bouge13a/pd_midi_synth/hardware/looper pins.xlsx

Looper board
PIN | NET name | pin type | Details
PE3 | "pad 0" | adc | to 10k pot
PE2 | "pad 1" | adc | to 10k pot
PE1 | "pad 2" | adc | to 10k pot
PE0 | "pad 3" | adc | to 10k pot
PD3 | "pad 4" | adc | to 10k pot
PD2 | "pad 5" | adc | to 10k pot
PD1 | "pad 6" | adc | to 10k pot
PD7 | "pad 7" | adc | to 10k pot
PE5 | "pad 8" | adc | to 10k fader
PE4 | "pad 9" | adc | to 10k fader
PB4 | "pad 10" | adc | to 10k fader
PB5 | "pad 11" | adc | to 10k fader
PA6 | "i2c 1 SCL" | I2C SCL | 4.7k pullup resistor
PA7 | "i2c 1 SDA" | I2C SDA | 4.7k pullup resistor
PB2 | "board sel" | GPI | to Vdd
PA0 | "UART0Rx" | UART RX | serial debug terminal
PA1 | "UART0Tx" | UART TX | serial debug terminal
PF3 | "green debug" | GPO | Green surface mount debug LED
PF1 | "red debug" | GPO | Red surface mount debug LED
PB1 | "led 0" | GPO | to momentary push button lamp
PF4 | "led 1" | GPO | to momentary push button lamp
PB6 | "led 2" | GPO | to momentary push button lamp
PB7 | "led 3" | GPO | to momentary push button lamp
PF0 | "led 4" | GPO | to momentary push button lamp
PB2 | "led 5" | GPO | to momentary push button lamp
PF0 | "led 6" | GPO | to momentary push button lamp
PB7 | "led 7" | GPO | to momentary push button lamp
PB0 | "loop 0" | GPI | to momentary push button
PB6 | "loop 1" | GPI | to momentary push button
PB3 | "loop 2" | GPI | to momentary push button
PA4 | "loop 3" | GPI | to momentary push button
PA5 | "loop 4" | GPI | to momentary push button
PC6 | "loop 5" | GPI | to momentary push button
PC7 | "loop 6" | GPI | to momentary push button
PD6 | "loop 7" | GPI | to momentary push button
PF2 | "effect button" | GPI | to momentary push button
PC4 | "UART1Rx" | UART Rx
PC5 | "UART1Tx" | UART Tx
