bouge13a/pd_midi_synth/hardware/MIDI controller pins.xlsx

MCU I, Midi Controller
PIN | NET name | pin type | Details
PE3 | "pad 0" | adc | forse sensing resistor/100k resistor voltage divider
PE2 | "pad 1" | adc | forse sensing resistor/100k resistor voltage divider
PE1 | "pad 2" | adc | forse sensing resistor/100k resistor voltage divider
PE0 | "pad 3" | adc | forse sensing resistor/100k resistor voltage divider
PD3 | "pad 4" | adc | forse sensing resistor/100k resistor voltage divider
PD2 | "pad 5" | adc | forse sensing resistor/100k resistor voltage divider
PD1 | "pad 6" | adc | forse sensing resistor/100k resistor voltage divider
PD7 | "pad 7" | adc | forse sensing resistor/100k resistor voltage divider
PE5 | "pad 8" | adc | forse sensing resistor/100k resistor voltage divider
PE4 | "pad 9" | adc | forse sensing resistor/100k resistor voltage divider
PB4 | "pad 10" | adc | forse sensing resistor/100k resistor voltage divider
PB5 | "pad 11" | adc | forse sensing resistor/100k resistor voltage divider
PA6 | "I2C1SCL" | I2C SCL | 4.7k pullup resistor
PA7 | "I2C1SDA" | I2C SDA | 4.7k pullup resistor
PB2 | "board sel" | GPI | to ground
PA0 | "UART0Rx" | UART RX | serial debug terminal
PA1 | "UART0Tx" | UART TX | serial debug terminal
PF3 | "green debug" | GPO | Green surface mount debug LED
PF1 | "red debug" | GPO | Red surface mount debug LED
PF4 | "channel up" | GPI | momentary push button
PD7 | "channel down" | GPI | momentary push button
PC6 | "p sense" | GPI | latching push button
PC7 | "octave up" | GPI | momentary push button
PD6 | "octave down" | GPI | momentary push button
PA5 | "SSI0Tx" | SSI Tx | to seven segment display
PA4 | "SSI0RX" | SSI Rx | to seven segment display
PA3 | "SSI0Fss" | SSI Fss | to seven segment display
PA2 | "SSI0CLK" | SSI CLK | to seven segment display
PC4 | "UART1Rx" | UART Rx
PC5 | "UART1Tx" | UART Tx
