bouge13a/pd_midi_synth/hardware/Top Part.JPG

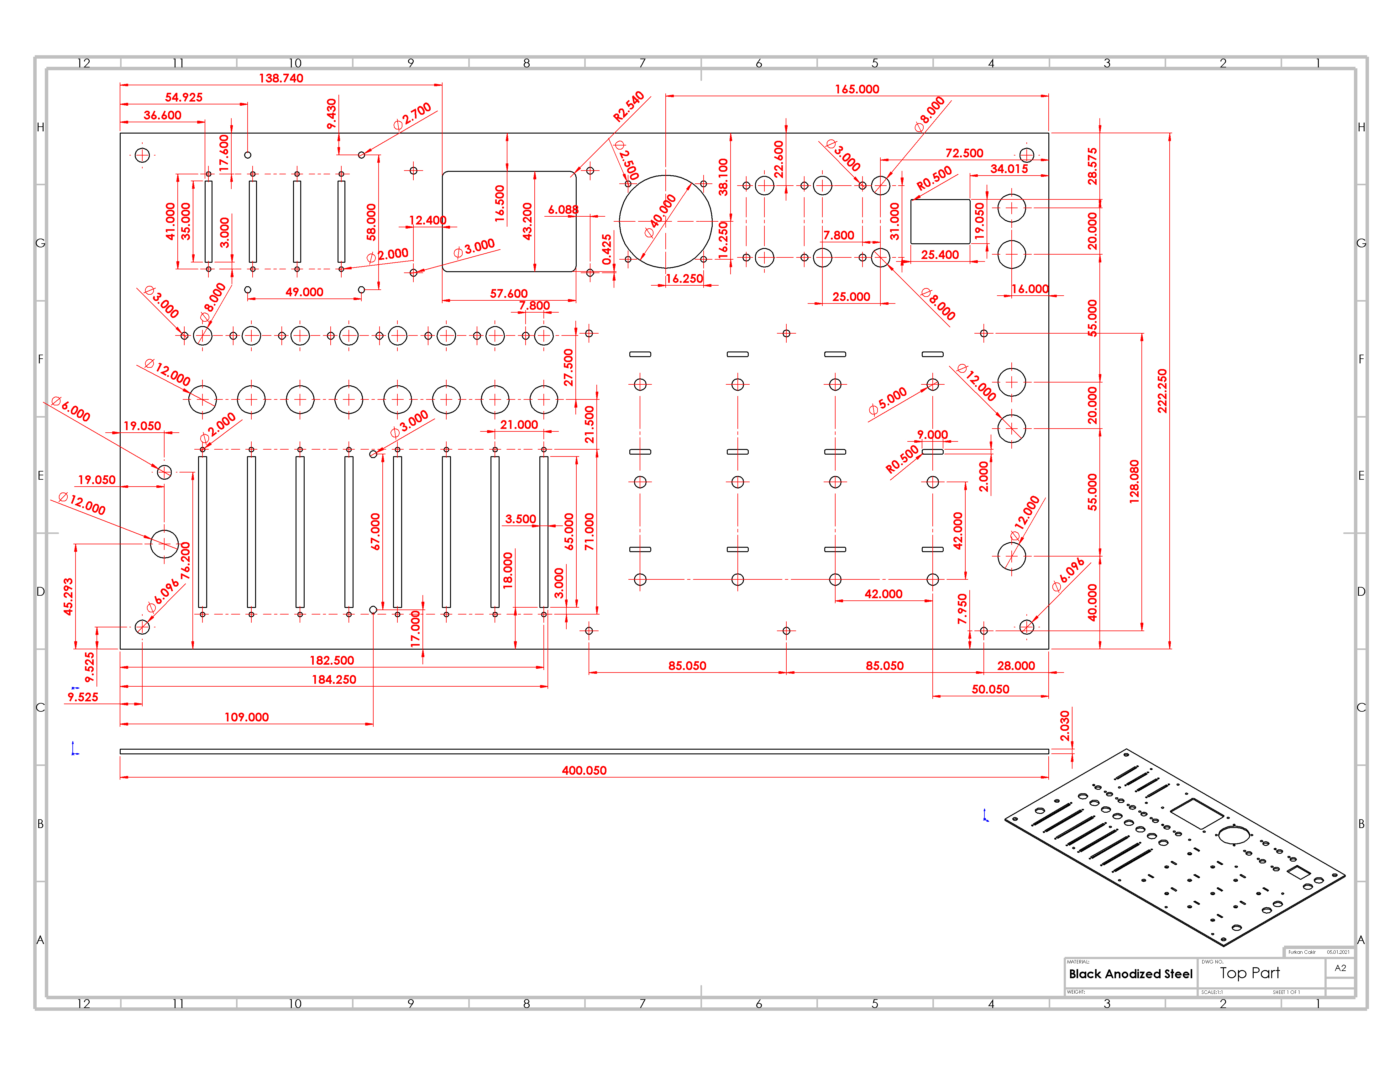
hardware/Top Part.JPG
