bouge13a/pd_midi_synth/hardware/Assembly.STEP

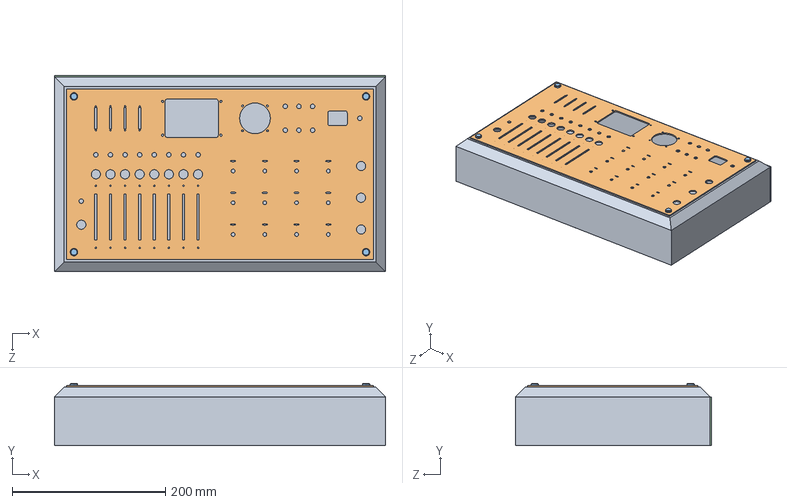
[picture p2: CAD file, 2022-02-10]
hardware/Assembly.STEP
431.8 x 81.2 x 256.0 mm
Base
Top
Screw x 4
Side
