bouge13a/pd_midi_synth/hardware/Top Part.STEP

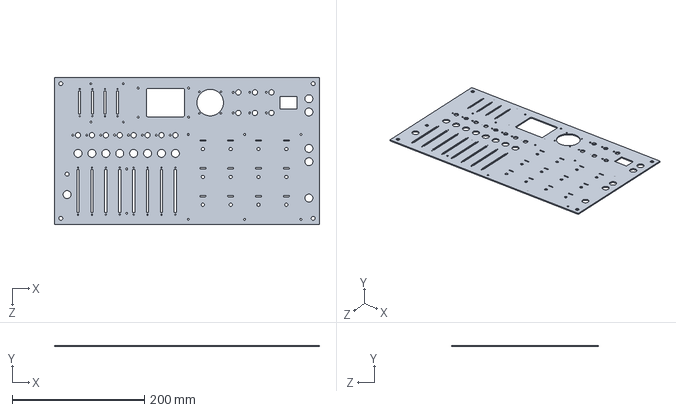
[picture p3: CAD file, 2022-02-10]
hardware/Top Part.STEP
400.1 x 2.03 x 222.2 mm
