bouge13a/pd_midi_synth/(list of files, cad)

Other CAD files:
Debug/driverlib/crc.obj
Debug/usb_midi/usbmidi_handlers.obj
Debug/utils/ustdlib.obj
Debug/driverlib/gpio.obj
Debug/usb_midi/usbmidi.obj
Debug/utils/uartstdio.obj
Debug/driverlib/qei.obj
Debug/usb_midi/usb_midi_fifo.obj
Debug/driverlib/uart.obj
Debug/driverlib/lcd.obj
Debug/driverlib/hibernate.obj
Debug/driverlib/fpu.obj
Debug/driverlib/emac.obj
Debug/driverlib/comp.obj
Debug/driverlib/flash.obj
Debug/driverlib/interrupt.obj
Debug/driverlib/usb.obj
Debug/driverlib/epi.obj
Debug/driverlib/adc.obj
Debug/driverlib/systick.obj
Debug/driverlib/cpu.obj
Debug/driverlib/timer.obj
Debug/driverlib/pwm.obj
Debug/driverlib/eeprom.obj
Debug/driverlib/mpu.obj
Debug/driverlib/can.obj
Debug/driverlib/sysexc.obj
Debug/driverlib/shamd5.obj
Debug/driverlib/udma.obj
Debug/driverlib/watchdog.obj
Debug/driverlib/sw_crc.obj
Debug/driverlib/des.obj
Debug/driverlib/aes.obj
Debug/driverlib/i2c.obj
Debug/driverlib/sysctl.obj
Debug/driverlib/ssi.obj
Debug/driverlib/epi_workaround_ccs.obj
hardware/Top Part.DWG
hardware/Top Part.DXF
hardware/Top Part.IGS
hardware/Top Part.SLDDRW
hardware/Top Part.SLDPRT
hardware/Top Part.STL
