bouge13a/pd_midi_synth/hardware/2D_Drawing.pdf.pdf

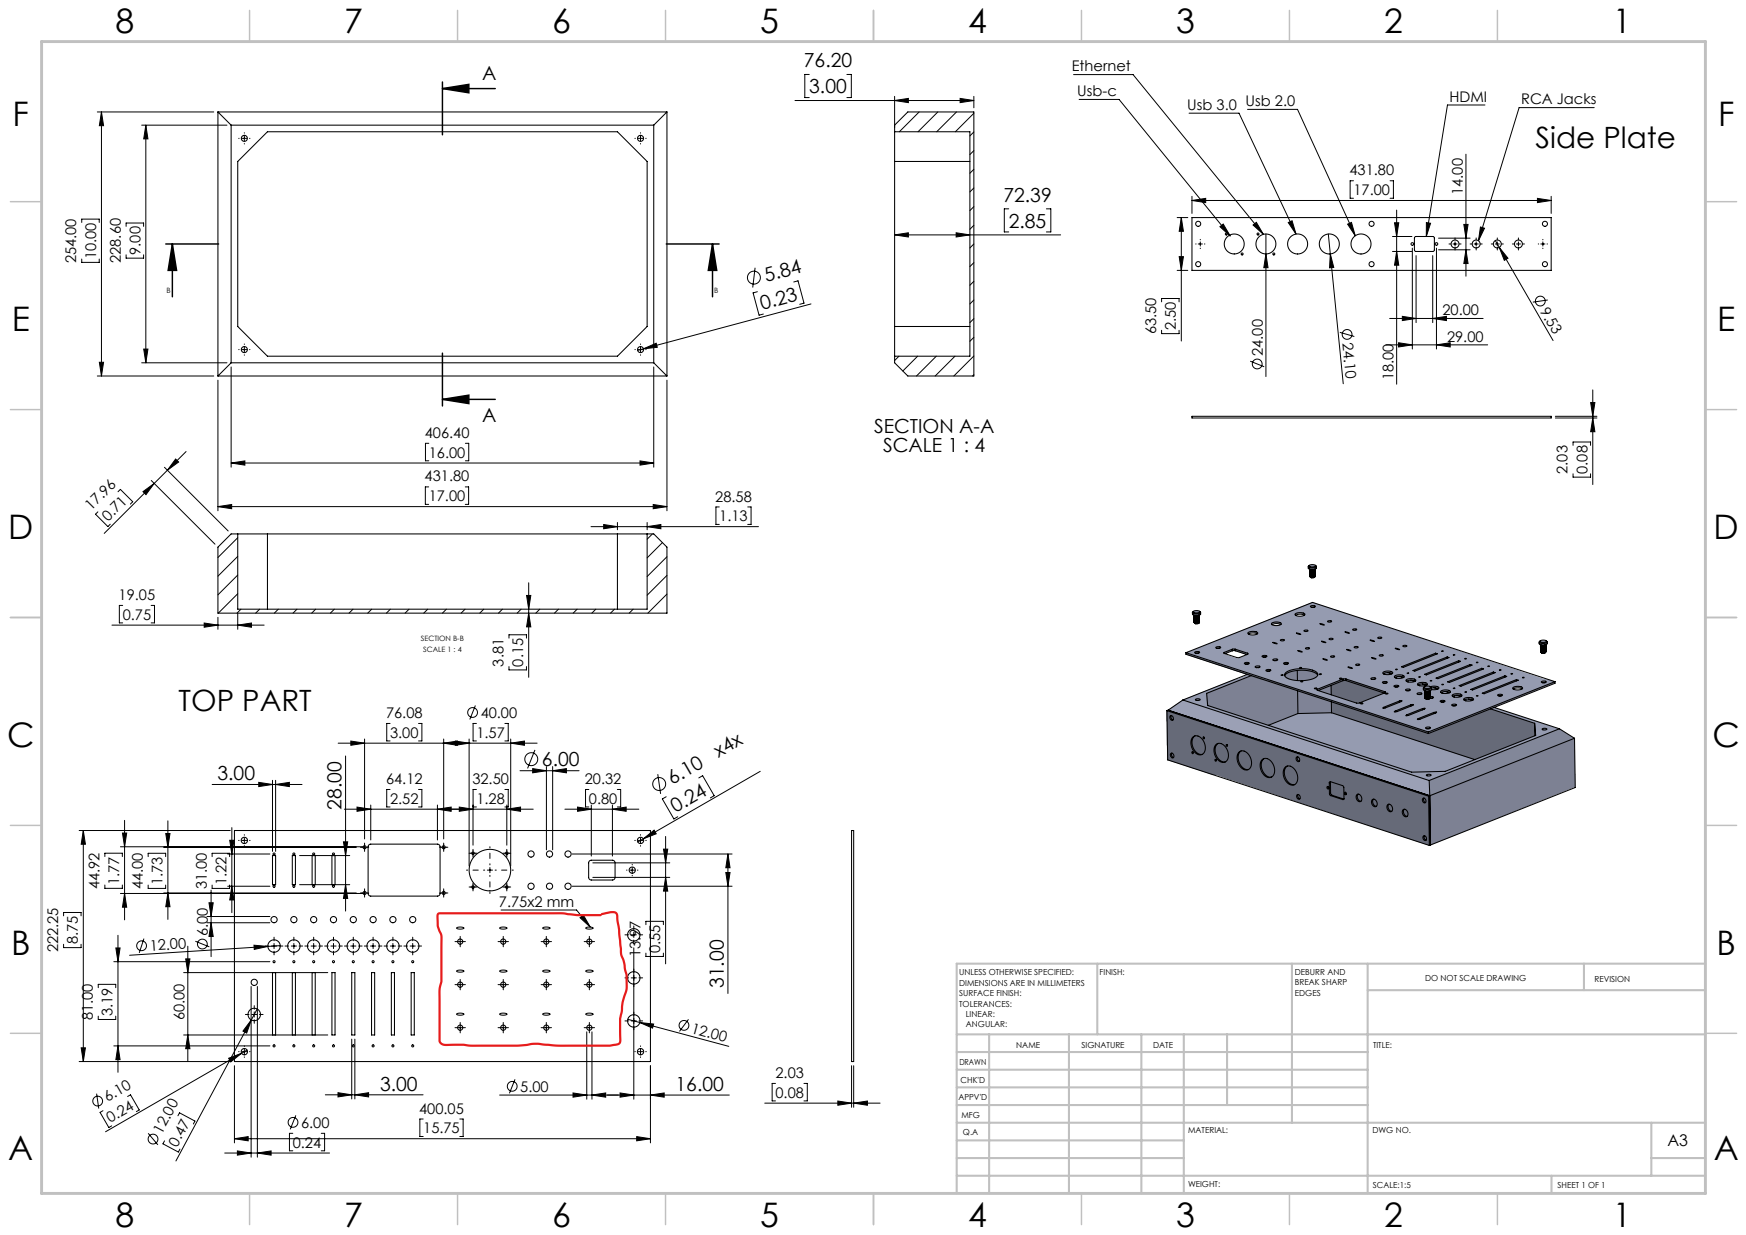
[picture p4: page 1]
SECTION A-A SCALE 1 : 4; SECTION B-B SCALE 1 : 4; Usb 3.0 Usb 2.0; HDMI; RCA Jacks 2.03 0.08; TOP PART; Side Plate; FINISH:; DEBURR AND; BREAK SHARP; DO NOT SCALE DRAWING; REVISION; SCALE:1:5; SHEET 1 OF 1

UNLESS OTHERWISE SPECIFIED:
DIMENSIONS ARE IN MILLIMETERS
SURFACE FINISH:
TOLERANCES:
LINEAR:
ANGULAR:

NAME | SIGNATURE | DATE | | | | TITLE:

DRAWN
CHK'D
APPV'D
MFG
Q.A | | | | MATERIAL: | DWG NO. | A3
