bouge13a/pd_midi_synth/hardware/Looper_Board/Looper_Board/PDF_Schematics/Looper_Board.pdf

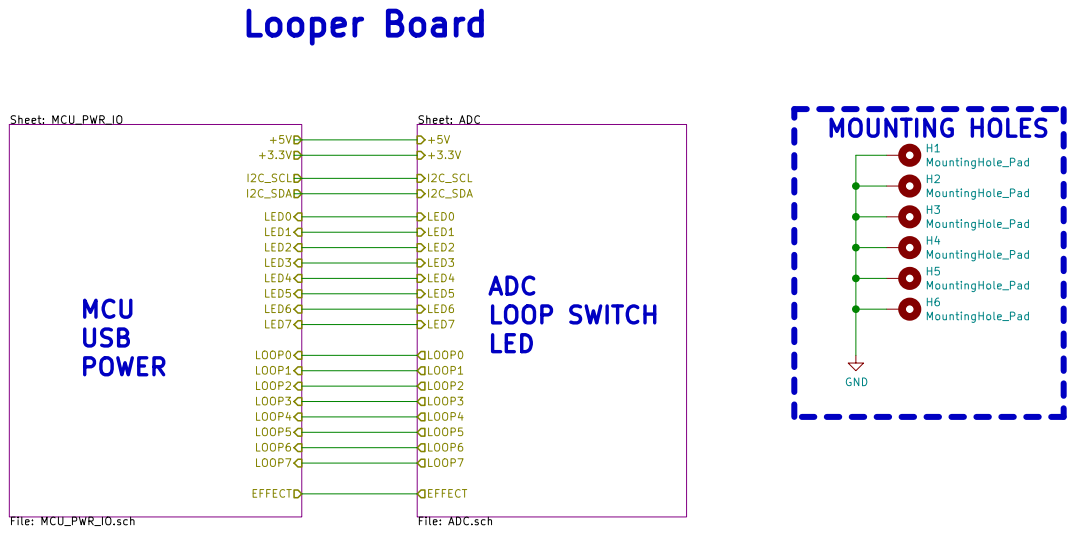
[picture p5: page 1]

Drawn by: Aravind
File: Looper_Board.sch Sheet: / Cadsims UK

Id: 1/3 Title: Looper Board

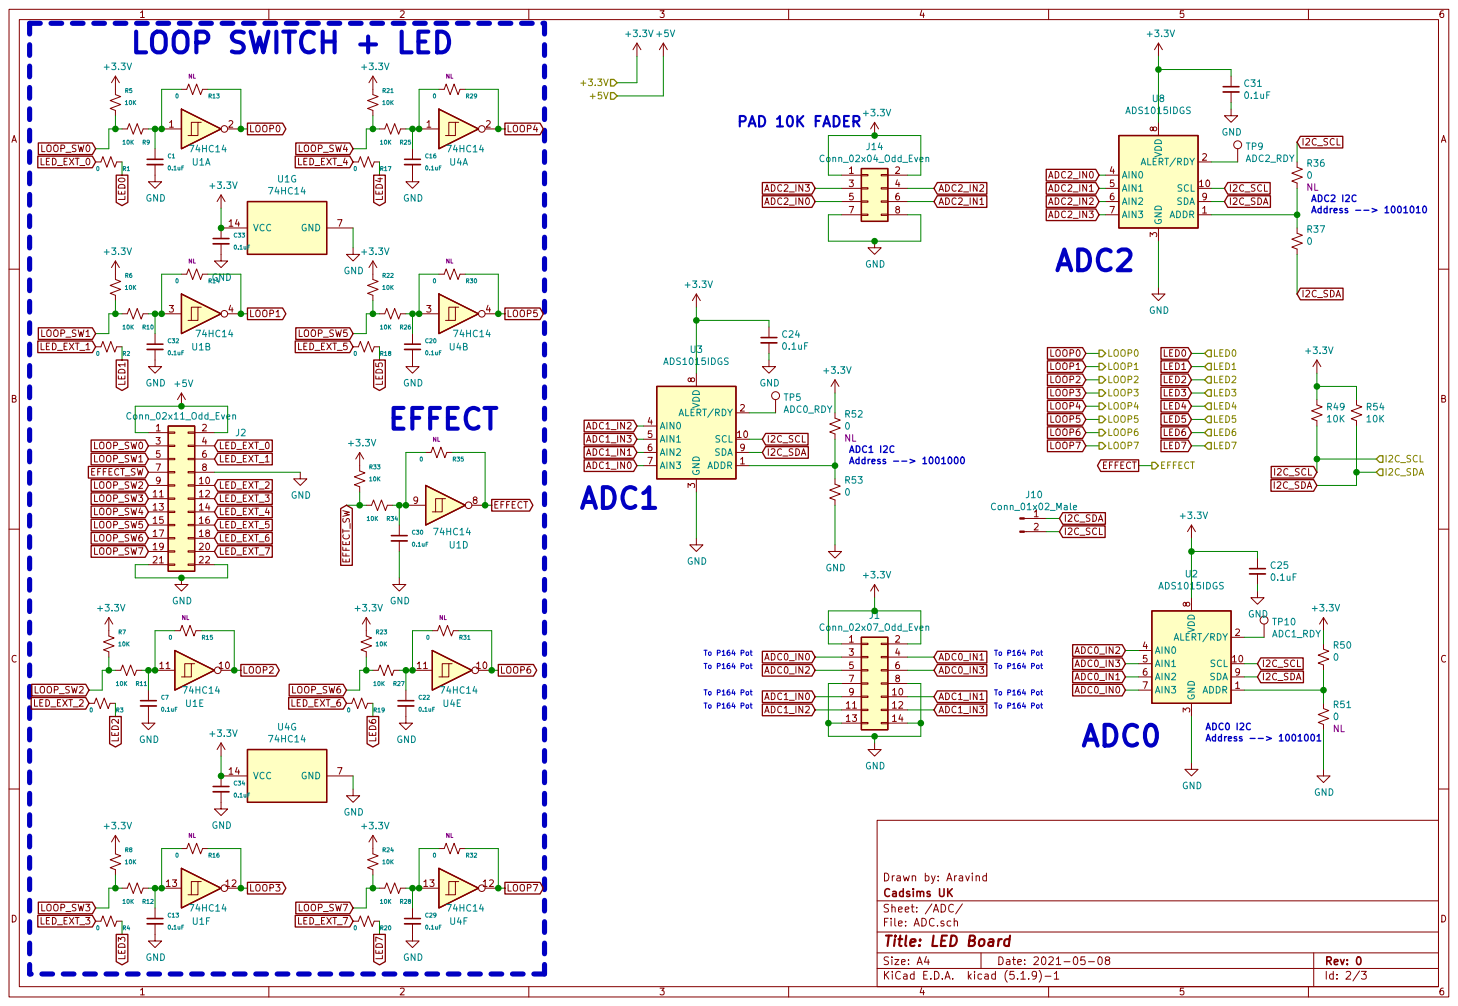
[picture p6: page 2]

To P164 Pot To P164 Pot LOOP SWITCH + LED

To P164 Pot

Drawn by: Aravind
File: ADC.sch Sheet: /ADC/ Cadsims UK

Id: 2/3 Title: LED Board

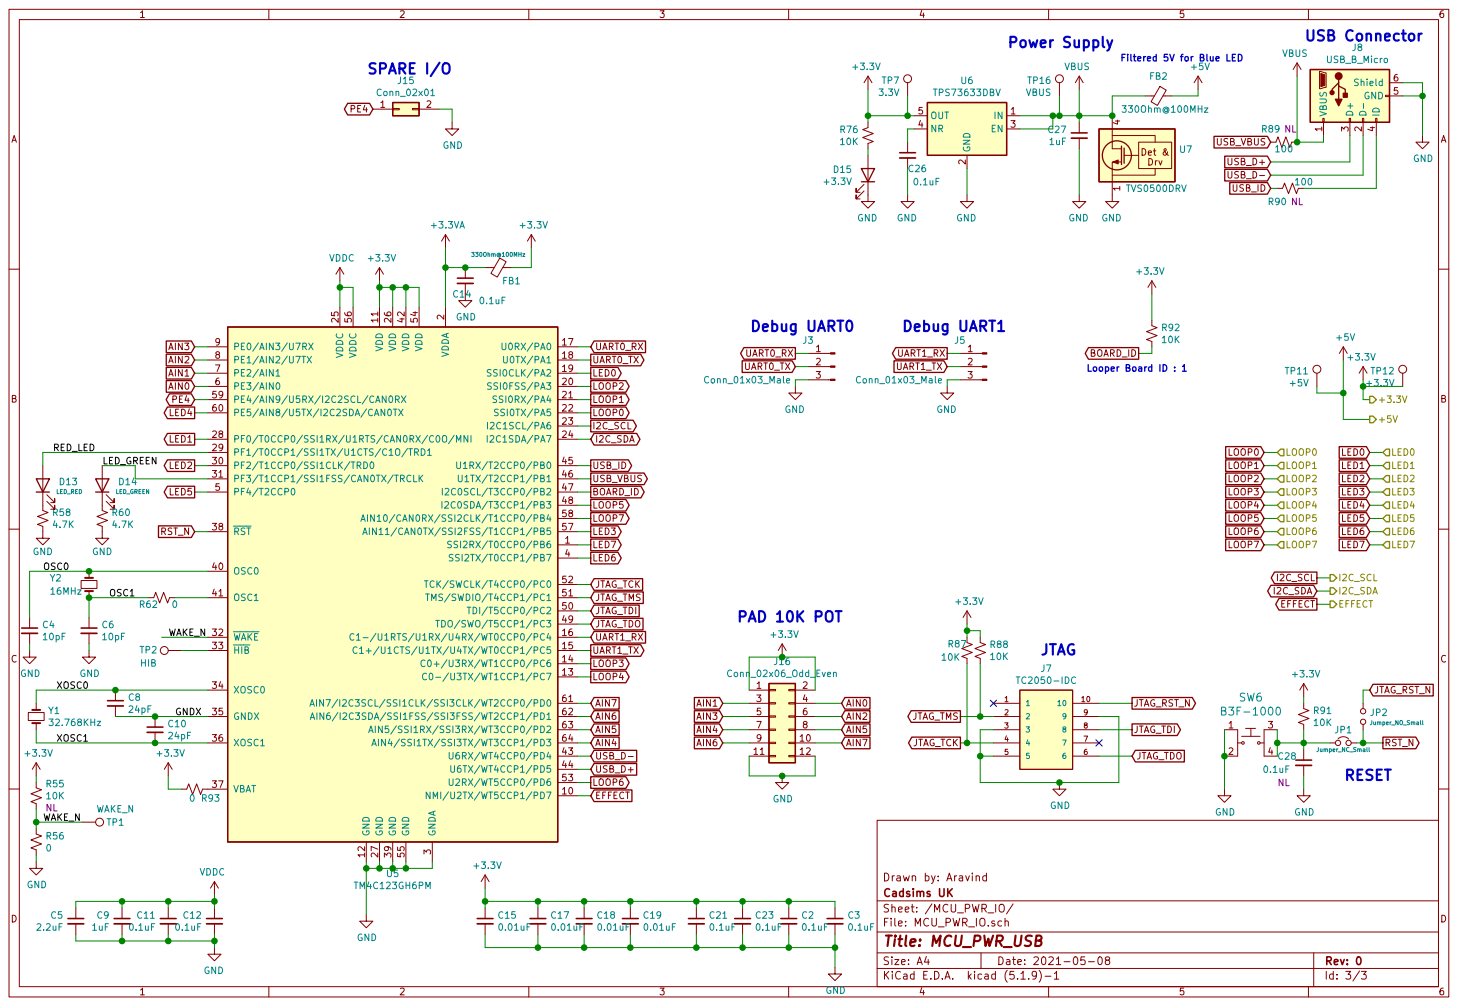
[picture p7: page 3]

Filtered 5V for Blue LED PAD 10K POT

3 PF2/T1CCP0/SSI1CLK/TRD0 30 PF3/T1CCP1/SSI1FSS/CAN0TX/TRCLK 31 WAKE 32 HIB 33 XOSC0 34 GNDX 35 XOSC1 36 VBAT 37 RST 38 GND 39 SSI2TX/T0CCP1/PB7 4 OSC0 40 OSC1 41 VDD 42 U6RX/WT4CCP0/PD4 43 U6TX/WT4CCP1/PD5 44 U1RX/T2CCP0/PB0 45 U1TX/T2CCP1/PB1 46

Drawn by: Aravind GND
