bouge13a/pd_midi_synth/hardware/MIDI_Board/LED_Board/PDF_Schematics/LED_Board.pdf

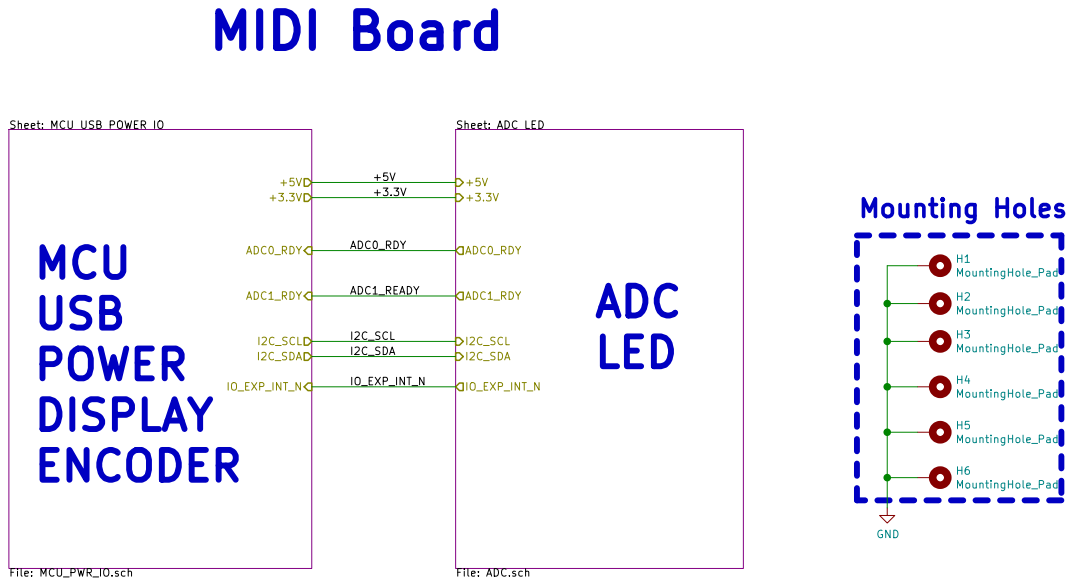
[picture p8: page 1]

Sheet: MCU USB POWER IO

File: LED_Board.sch Sheet: / Cadsims UK Ltd Drawn by: Aravind

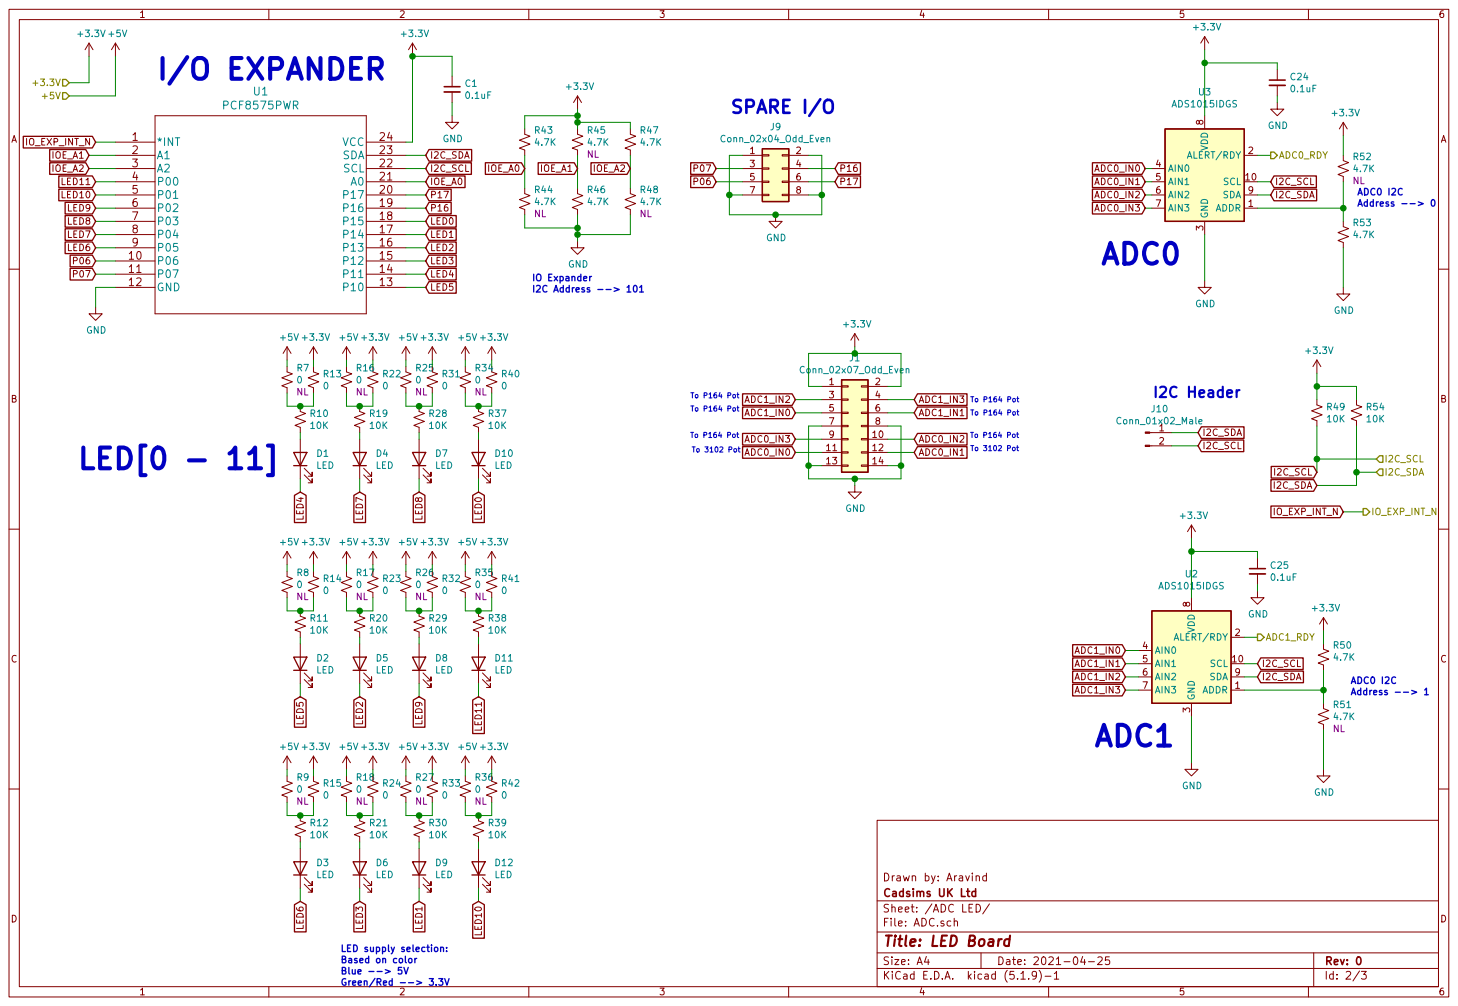
[picture p9: page 2]

File: ADC.sch Sheet: /ADC LED/ Cadsims UK Ltd Drawn by: Aravind R17

Id: 2/3 Title: LED Board

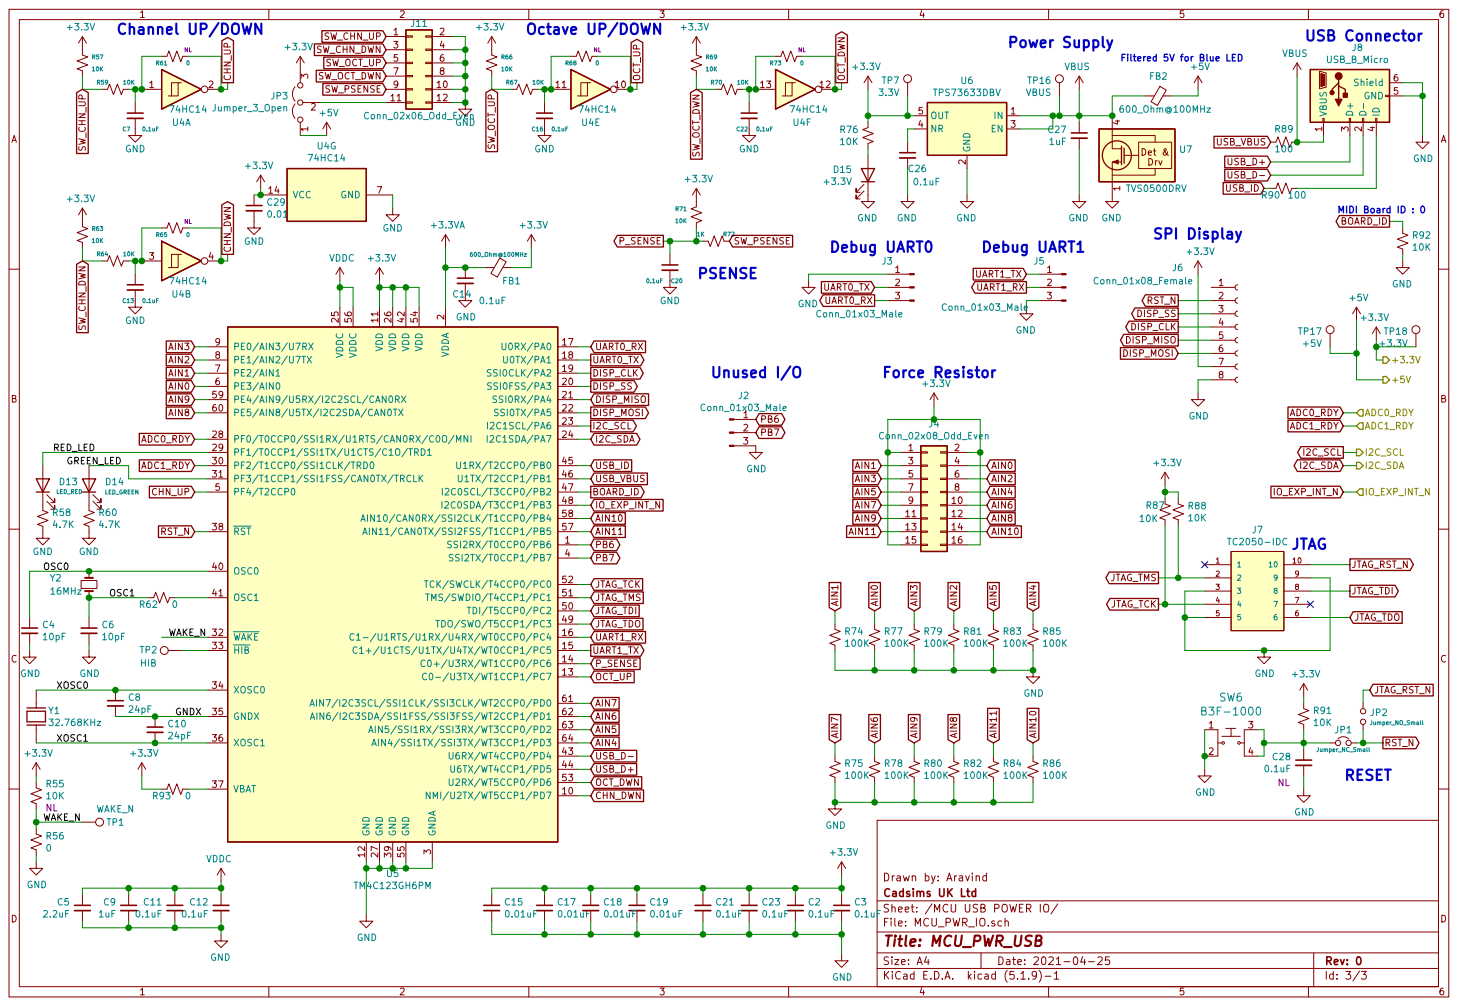
[picture p10: page 3]

Filtered 5V for Blue LED Octave UP/DOWN

MIDI Board ID : 0 Power Supply
100VBUS R83
VBUS GND

3 PF2/T1CCP0/SSI1CLK/TRD0 30 PF3/T1CCP1/SSI1FSS/CAN0TX/TRCLK 31 WAKE 32 HIB 33 XOSC0 34 GNDX 35 XOSC1 36 VBAT 37 RST 38 GND 39 SSI2TX/T0CCP1/PB7 4 OSC0 40 OSC1 41 VDD 42 U6RX/WT4CCP0/PD4 43 U6TX/WT4CCP1/PD5 44 U1RX/T2CCP0/PB0 45 U1TX/T2CCP1/PB1 46

9 | 10
11 | 12
13 | 14
15 | 16

File: MCU_PWR_IO.sch Sheet: /MCU USB POWER IO/ Cadsims UK Ltd Drawn by: Aravind
