bouge13a/pd_midi_synth/hardware/Looper_Board/Looper_Board/Looper_Board.kicad_pcb

## KiCad design hardware/Looper_Board/Looper_Board/Looper_Board.kicad_pcb (2022-02-10)

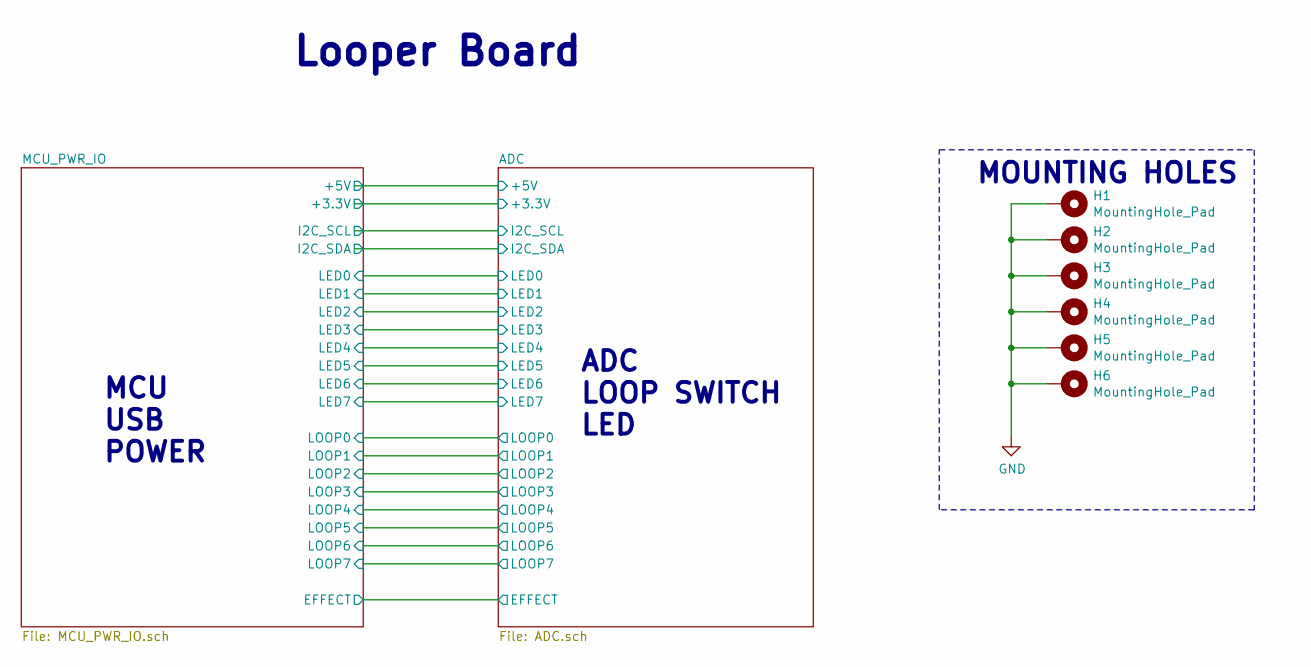
[picture p11: schematic Looper_Board.sch, Looper Board]

Parts:
H1, H2, H3, H4, H5, H6: MountingHole_Pad; MountingHole_3mm_Pad_Via

Connections:
GND: H1.1, H2.1, H3.1, H4.1, H5.1, H6.1; also elsewhere on the board

Notes on the sheet:
ADC LOOP SWITCH LED
MCU USB POWER
Looper Board
MOUNTING HOLES

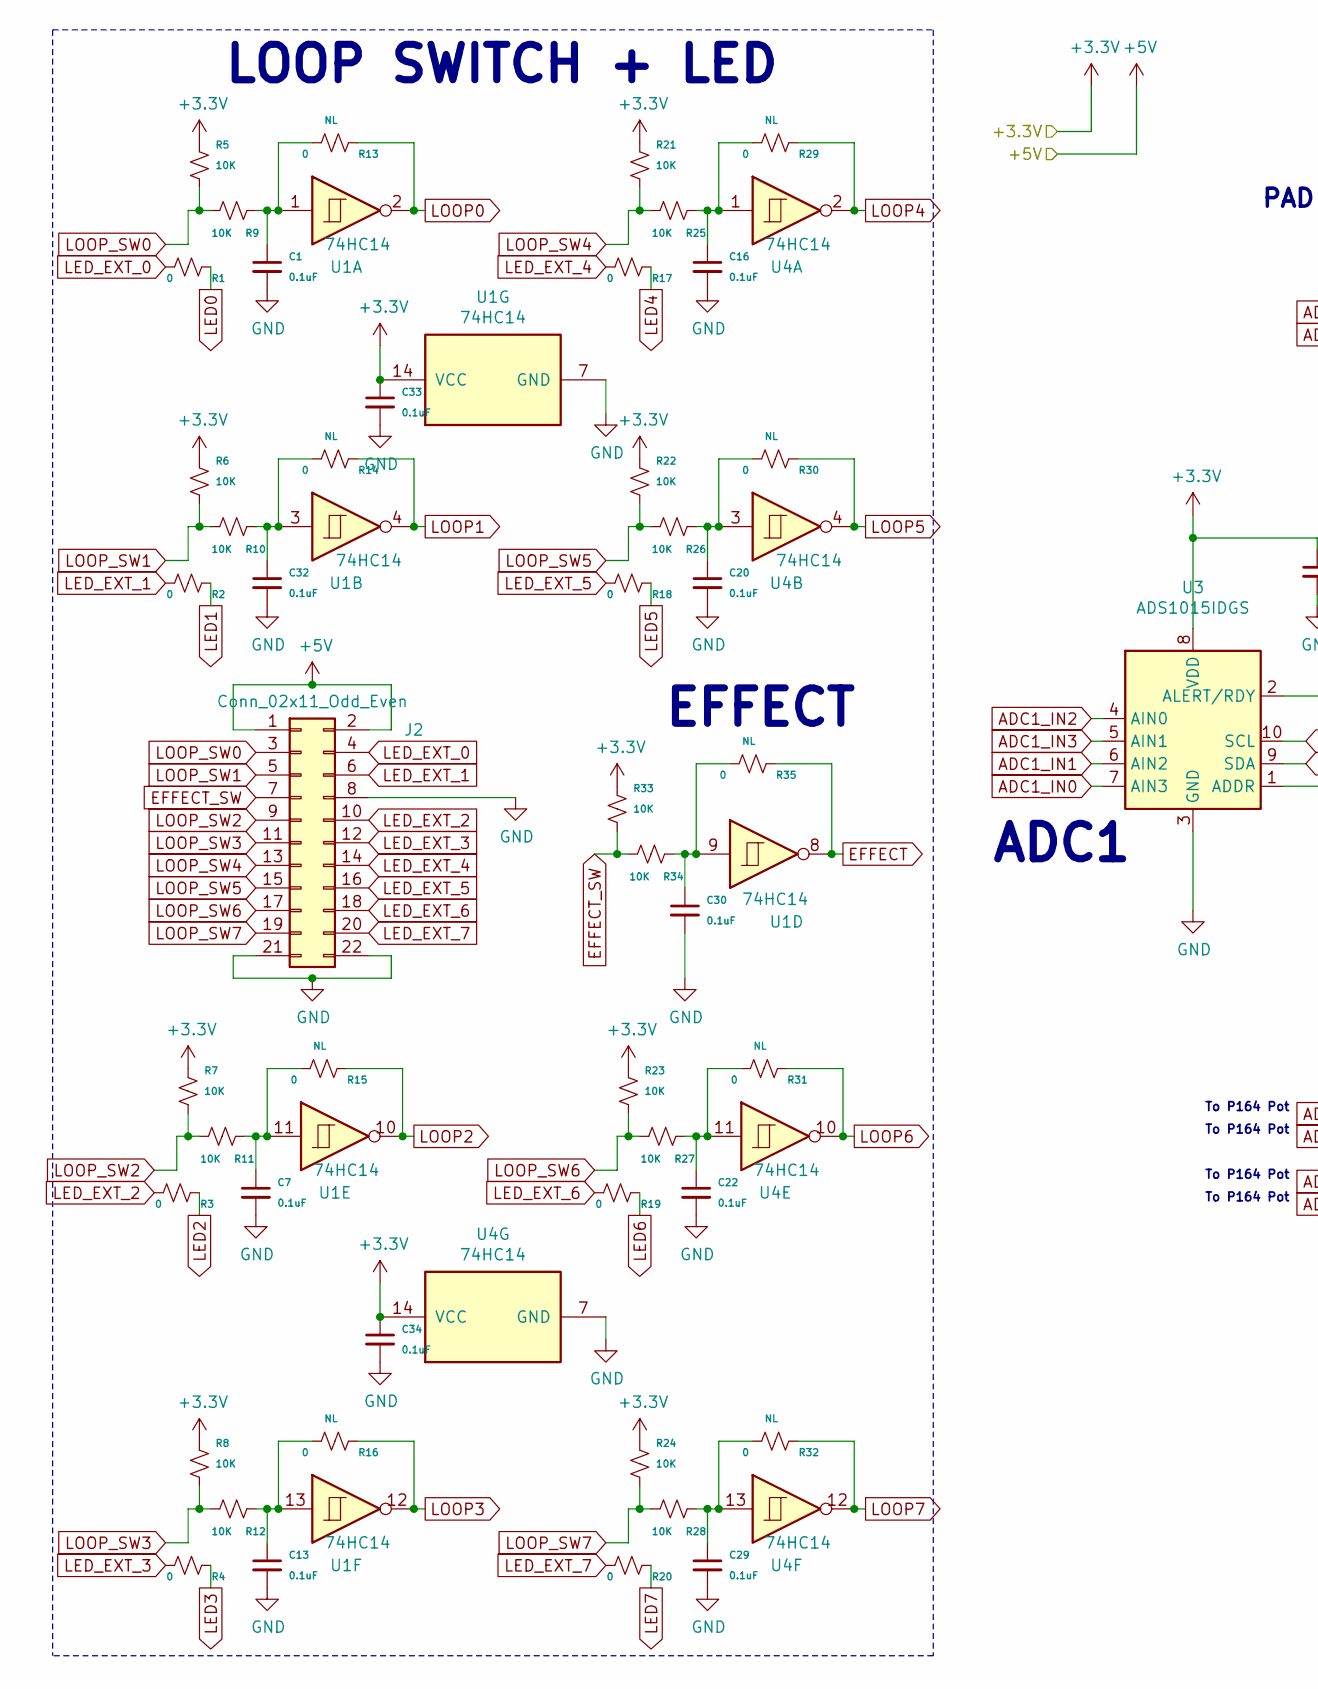
[picture p12: schematic ADC.sch, LED Board, part in row 1, column 1]

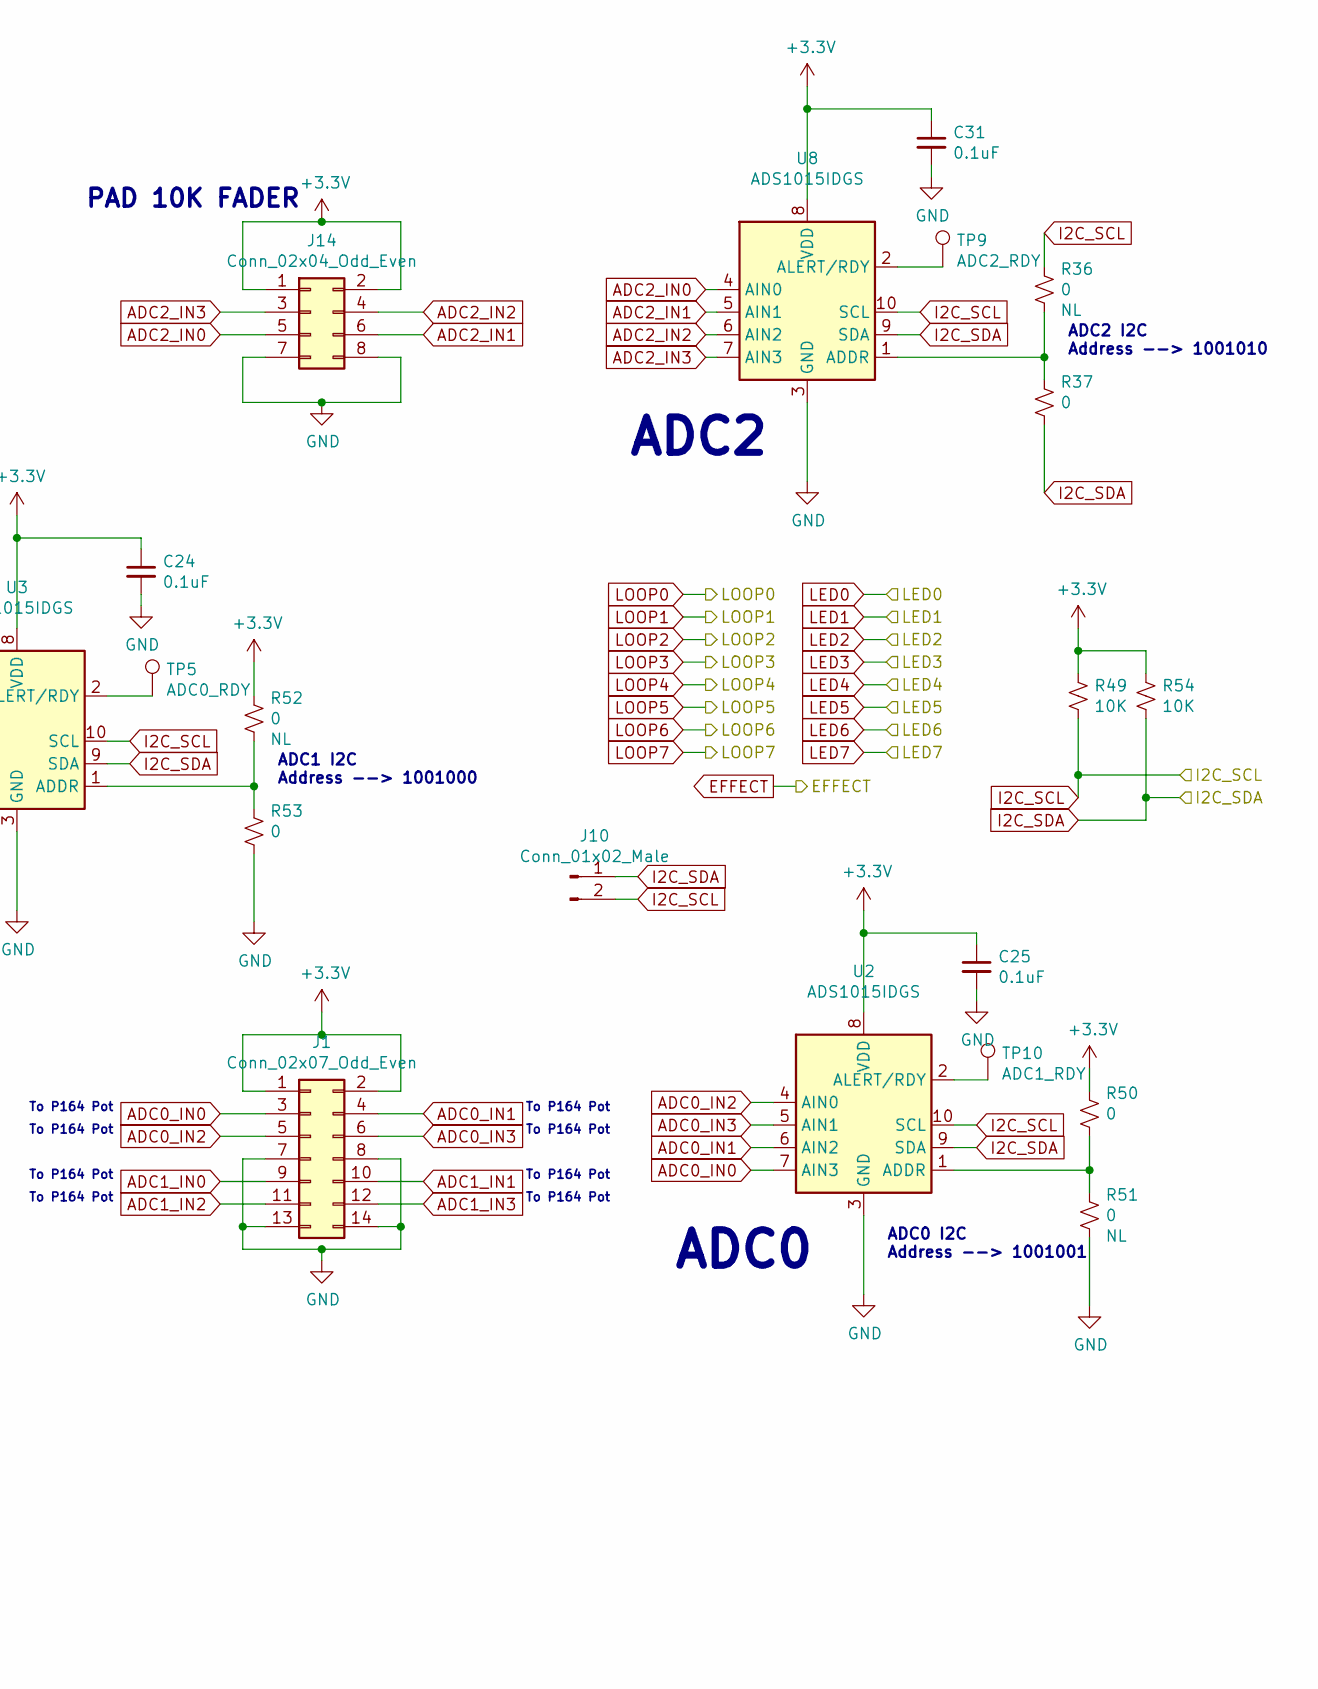
[picture p13: schematic ADC.sch, LED Board, part in row 1, column 2]

Parts:
C1, C7, C13, C16, C20, C22, C24, C25, C29, C30, C31, C32, C33, C34: 0.1uF; C_0402_1005Metric_Pad0.74x0.62mm_HandSolder
J1: Conn_02x07_Odd_Even; PinHeader_2x07_P2.54mm_Horizontal
J2: Conn_02x11_Odd_Even; PinHeader_2x11_P2.54mm_Horizontal
J10: Conn_01x02_Male; PinHeader_1x02_P2.54mm_Vertical
J14: Conn_02x04_Odd_Even; PinHeader_2x04_P2.54mm_Horizontal
R1, R2, R3, R4, R13, R14, R15, R16, R17, R18, R19, R20, R29, R30, R31, R32, R35, R36, R37, R50, R51, R52, R53: 0; R_0402_1005Metric_Pad0.72x0.64mm_HandSolder
R5, R6, R7, R8, R9, R10, R11, R12, R21, R22, R23, R24, R25, R26, R27, R28, R33, R34, R49, R54: 10K; R_0402_1005Metric_Pad0.72x0.64mm_HandSolder
TP5: ADC0_RDY; TestPoint_Pad_D1.5mm
TP9: ADC2_RDY; TestPoint_Pad_D1.5mm
TP10: ADC1_RDY; TestPoint_Pad_D1.5mm
U1, U4: 74HC14; SOIC-14_3.9x8.7mm_P1.27mm
U2, U3, U8: ADS1015IDGS; VSSOP-10_3x3mm_P0.5mm

Connections:
+3V3: C24.1, C25.1, C31.1, C33.1, C34.1, J1.1, J1.2, J14.1, J14.2, R5.1, R6.1, R7.1, R8.1, R21.1, R22.1, R23.1, R24.1, R33.1, R49.1, R50.1, R52.1, R54.1, U1.14 (VCC), U2.8 (VDD), U3.8 (VDD), U4.14 (VCC), U8.8 (VDD); also elsewhere on the board
+5V: J2.1, J2.2; also elsewhere on the board
ADC0_IN0: J1.3, U2.7 (AIN3)
ADC0_IN1: J1.4, U2.6 (AIN2)
ADC0_IN2: J1.5, U2.4 (AIN0)
ADC0_IN3: J1.6, U2.5 (AIN1)
ADC1_IN0: J1.9, U3.7 (AIN3)
ADC1_IN1: J1.10, U3.6 (AIN2)
ADC1_IN2: J1.11, U3.4 (AIN0)
ADC1_IN3: J1.12, U3.5 (AIN1)
ADC2_IN0: J14.5, U8.4 (AIN0)
ADC2_IN1: J14.6, U8.5 (AIN1)
ADC2_IN2: J14.4, U8.6 (AIN2)
ADC2_IN3: J14.3, U8.7 (AIN3)
EFFECT: R35.1, U1.8; also elsewhere on the board
EFFECT_SW: J2.7, R33.2, R34.2
GND: C1.2, C7.2, C13.2, C16.2, C20.2, C22.2, C24.2, C25.2, C29.2, C30.2, C31.2, C32.2, C33.2, C34.2, J1.7, J1.8, J1.13, J1.14, J2.8, J2.21, J2.22, J14.7, J14.8, R51.2, R53.2, U1.7 (GND), U2.3 (GND), U3.3 (GND), U4.7 (GND), U8.3 (GND); also elsewhere on the board
I2C_SCL: J10.2, R36.1, R49.2, U2.10 (SCL), U3.10 (SCL), U8.10 (SCL); also elsewhere on the board
I2C_SDA: J10.1, R37.2, R54.2, U2.9 (SDA), U3.9 (SDA), U8.9 (SDA); also elsewhere on the board
LED0: R1.1; also elsewhere on the board
LED1: R2.1; also elsewhere on the board
LED2: R3.1; also elsewhere on the board
LED3: R4.1; also elsewhere on the board
LED4: R17.1; also elsewhere on the board
LED5: R18.1; also elsewhere on the board
LED6: R19.1; also elsewhere on the board
LED7: R20.1; also elsewhere on the board
LED_EXT_0: J2.4, R1.2
LED_EXT_1: J2.6, R2.2
LED_EXT_2: J2.10, R3.2
LED_EXT_3: J2.12, R4.2
LED_EXT_4: J2.14, R17.2
LED_EXT_5: J2.16, R18.2
LED_EXT_6: J2.18, R19.2
LED_EXT_7: J2.20, R20.2
LOOP0: R13.1, U1.2; also elsewhere on the board
LOOP1: R14.1, U1.4; also elsewhere on the board
LOOP2: R15.1, U1.10; also elsewhere on the board
LOOP3: R16.1, U1.12; also elsewhere on the board
LOOP4: R29.1, U4.2; also elsewhere on the board
LOOP5: R30.1, U4.4; also elsewhere on the board
LOOP6: R31.1, U4.10; also elsewhere on the board
LOOP7: R32.1, U4.12; also elsewhere on the board
LOOP_SW0: J2.3, R5.2, R9.2
LOOP_SW1: J2.5, R6.2, R10.2
LOOP_SW2: J2.9, R7.2, R11.2
LOOP_SW3: J2.11, R8.2, R12.2
LOOP_SW4: J2.13, R21.2, R25.2
LOOP_SW5: J2.15, R22.2, R26.2
LOOP_SW6: J2.17, R23.2, R27.2
LOOP_SW7: J2.19, R24.2, R28.2
unnamed: C1.1, R9.1, R13.2, U1.1
unnamed: C7.1, R11.1, R15.2, U1.11
unnamed: C13.1, R12.1, R16.2, U1.13
unnamed: C16.1, R25.1, R29.2, U4.1
unnamed: C20.1, R26.1, R30.2, U4.3
unnamed: C22.1, R27.1, R31.2, U4.11
unnamed: C29.1, R28.1, R32.2, U4.13
unnamed: C30.1, R34.1, R35.2, U1.9
unnamed: C32.1, R10.1, R14.2, U1.3
unnamed: R36.2, R37.1, U8.1 (ADDR)
unnamed: R50.2, R51.1, U2.1 (ADDR)
unnamed: R52.2, R53.1, U3.1 (ADDR)
unnamed: TP5.1, U3.2 (ALERT/RDY)
unnamed: TP9.1, U8.2 (ALERT/RDY)
unnamed: TP10.1, U2.2 (ALERT/RDY)

Notes on the sheet:
To P164 Pot
ADC0
ADC1
ADC1 I2C Address --> 1001000
ADC0 I2C Address --> 1001001
LOOP SWITCH + LED
EFFECT
ADC2
ADC2 I2C Address --> 1001010
PAD 10K FADER

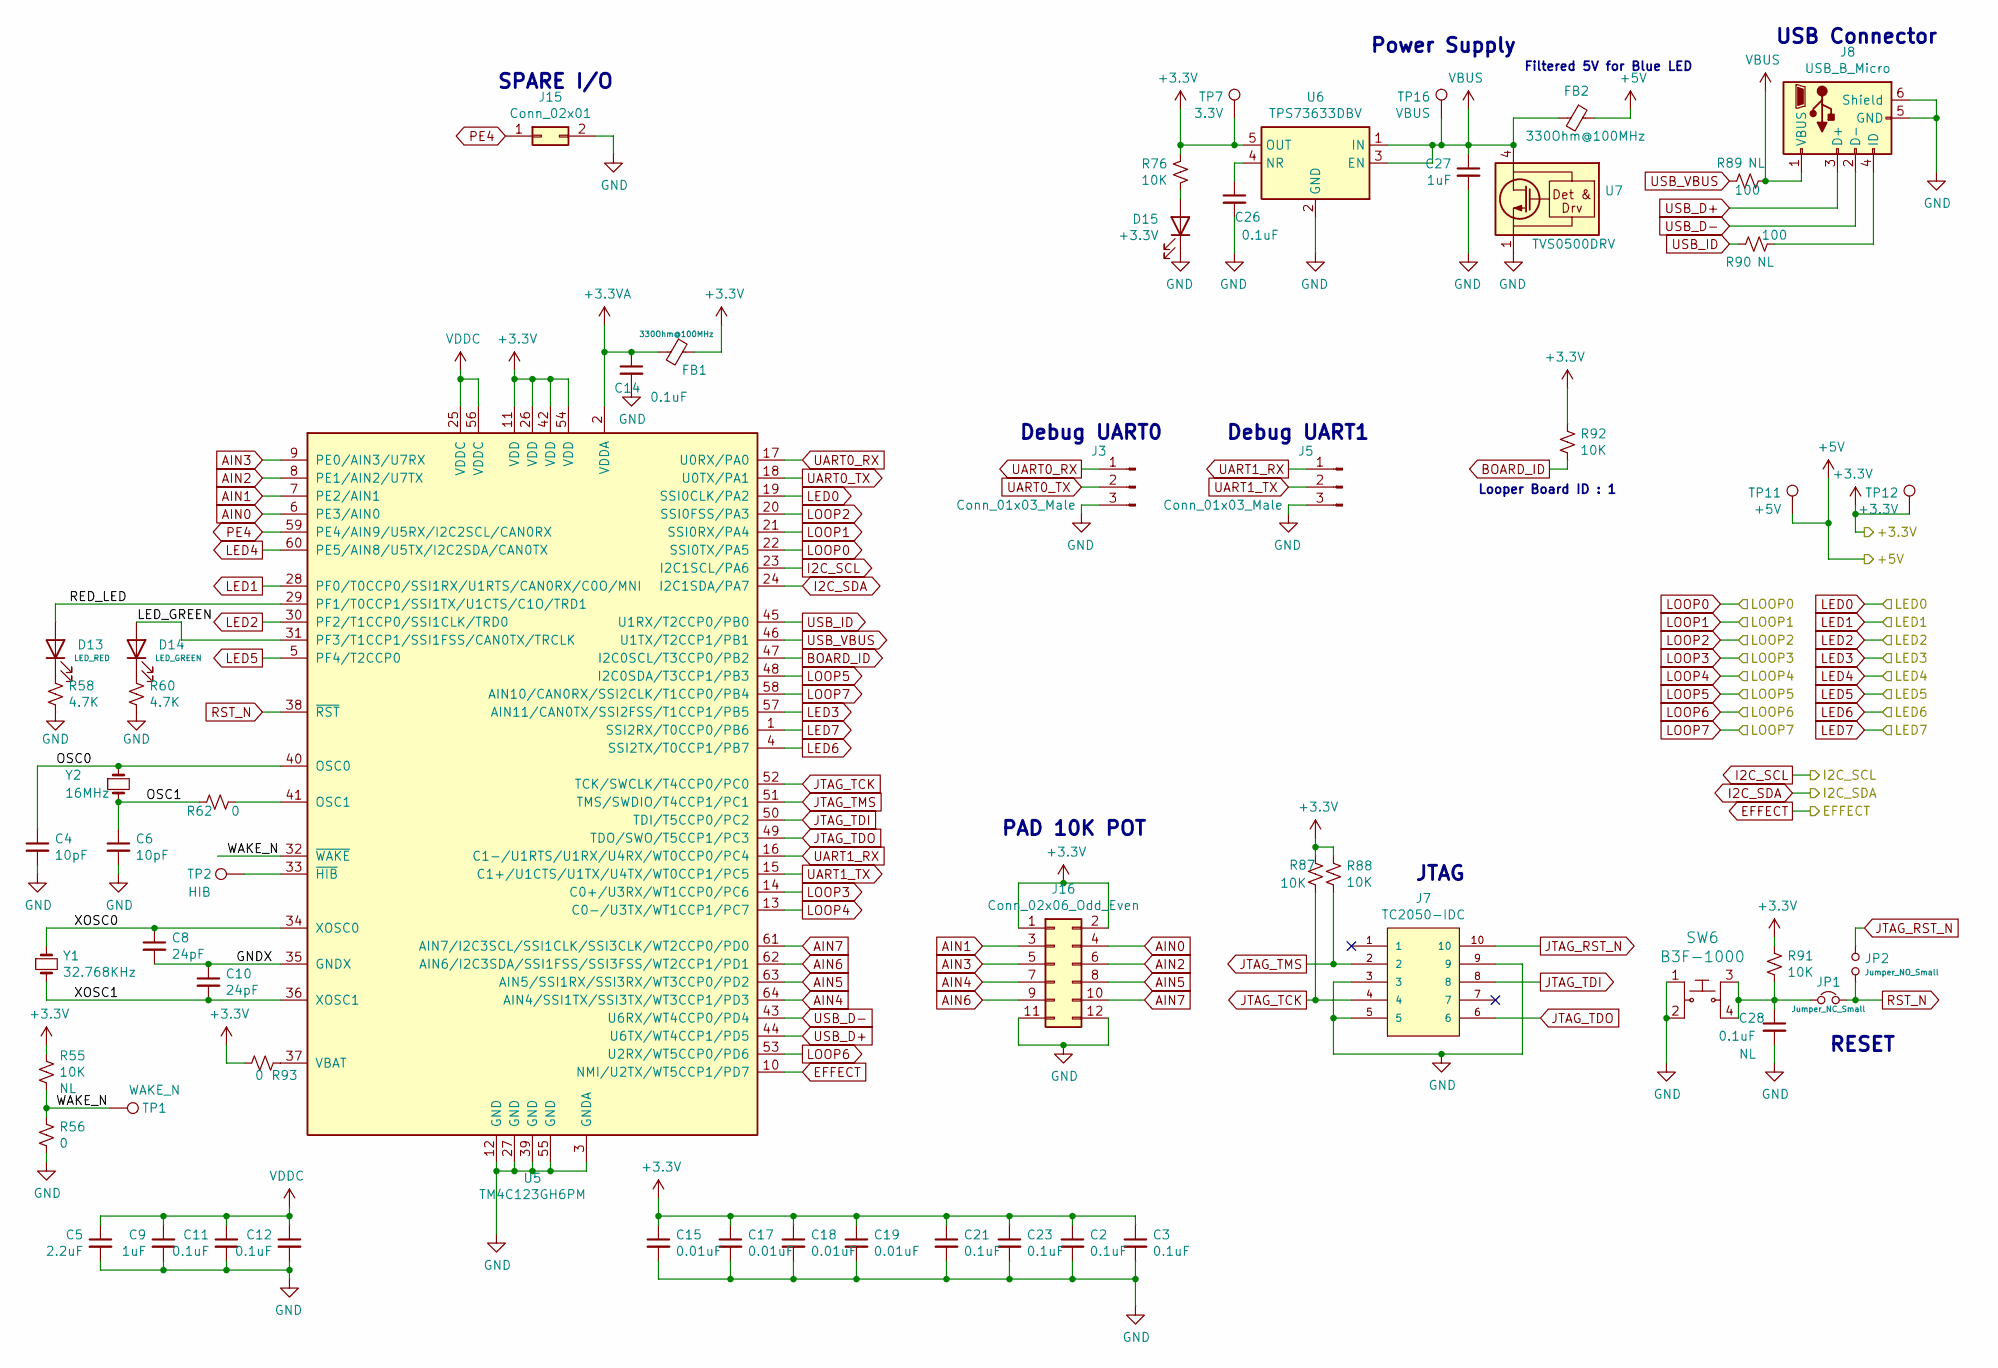
[picture p14: schematic MCU_PWR_IO.sch, MCU_PWR_USB]

Parts:
C2, C3, C11, C12, C14, C21, C23, C26, C28: 0.1uF; C_0402_1005Metric_Pad0.74x0.62mm_HandSolder
C4, C6: 10pF; C_0402_1005Metric_Pad0.74x0.62mm_HandSolder
C5: 2.2uF; C_0603_1608Metric_Pad1.08x0.95mm_HandSolder
C8, C10: 24pF; C_0402_1005Metric_Pad0.74x0.62mm_HandSolder
C9, C27: 1uF; C_0402_1005Metric_Pad0.74x0.62mm_HandSolder
C15, C17, C18, C19: 0.01uF; C_0402_1005Metric_Pad0.74x0.62mm_HandSolder
D13: LED_RED; LED_0603_1608Metric
D14: LED_GREEN; LED_0603_1608Metric
D15: +3.3V; LED_0603_1608Metric
FB1: 330Ohm@100MHz; L_0805_2012Metric_Pad1.15x1.40mm_HandSolder; MfrPart GZ2012D601TF
FB2: 330Ohm@100MHz; L_0805_2012Metric_Pad1.15x1.40mm_HandSolder; MfrPart BLM18BB331SN1D
J3, J5: Conn_01x03_Male; PinHeader_1x03_P2.54mm_Vertical
J7: TC2050-IDC; TAG-CONNECT_TC2050-IDC; PARTREV A
J8: USB_B_Micro; USB_Micro-AB_Molex_47590-0001
J15: Conn_02x01; PinHeader_2x01_P2.54mm_Vertical
J16: Conn_02x06_Odd_Even; PinHeader_2x06_P2.54mm_Horizontal
JP1: Jumper_NC_Small; PinHeader_1x02_P2.54mm_Vertical
JP2: Jumper_NO_Small; PinHeader_1x02_P2.54mm_Vertical
R55, R76, R87, R88, R91, R92: 10K; R_0402_1005Metric_Pad0.72x0.64mm_HandSolder
R56, R62, R93: 0; R_0402_1005Metric_Pad0.72x0.64mm_HandSolder
R58, R60: 4.7K; R_0402_1005Metric_Pad0.72x0.64mm_HandSolder
R89, R90: 100; R_0402_1005Metric_Pad0.72x0.64mm_HandSolder
SW6: B3F-1000; SW_SPST_Omron_B3FS-100xP; MPN B3F-1000; Digi-Key_PN SW400-ND
TP1: WAKE_N; TestPoint_Pad_D1.5mm
TP2: HIB; TestPoint_Pad_D1.5mm
TP7: 3.3V; TestPoint_Pad_D1.5mm
TP11: +5V; TestPoint_Pad_D1.5mm
TP12: +3.3V; TestPoint_Pad_D1.5mm
TP16: VBUS; TestPoint_Pad_D1.5mm
U5: TM4C123GH6PM; LQFP-64_10x10mm_P0.5mm
U6: TPS73633DBV; SOT-23-5
U7: TVS0500DRV; WSON-6-1EP_2x2mm_P0.65mm_EP1x1.6mm
Y1: 32.768KHz; XTAL_AB26TRB-32.768KHZ-T
Y2: 16MHz; CRYSTAL_5_3.2MM

Connections:
+3.3VA: C14.1, FB1.2, U5.2 (VDDA)
+3V3: C2.1, C3.1, C15.1, C17.1, C18.1, C19.1, C21.1, C23.1, FB1.1, J16.1, J16.2, R55.1, R76.1, R87.1, R88.1, R91.1, R92.1, R93.2, TP7.1, TP12.1, U5.11 (VDD), U5.26 (VDD), U5.42 (VDD), U5.54 (VDD), U6.5 (OUT); also elsewhere on the board
+5V: FB2.1, TP11.1; also elsewhere on the board
/MCU_PWR_IO/GNDX: C8.2, C10.1, U5.35 (GNDX)
/MCU_PWR_IO/LED_GREEN: D14.2 (A), U5.31 (PF3/T1CCP1/SSI1FSS/CAN0TX/TRCLK)
/MCU_PWR_IO/OSC0: C4.1, U5.40 (OSC0), Y2.1
/MCU_PWR_IO/OSC1: C6.1, R62.2, Y2.2
/MCU_PWR_IO/RED_LED: D13.2 (A), U5.29 (PF1/T0CCP1/SSI1TX/U1CTS/C1O/TRD1)
/MCU_PWR_IO/WAKE_N: R55.2, R56.1, TP1.1, U5.32 (~WAKE~)
/MCU_PWR_IO/XOSC0: C8.1, U5.34 (XOSC0), Y1.1
/MCU_PWR_IO/XOSC1: C10.2, U5.36 (XOSC1), Y1.2
AIN0: J16.4, U5.6 (PE3/AIN0)
AIN1: J16.3, U5.7 (PE2/AIN1)
AIN2: J16.6, U5.8 (PE1/AIN2/U7TX)
AIN3: J16.5, U5.9 (PE0/AIN3/U7RX)
AIN4: J16.7, U5.64 (AIN4/SSI1TX/SSI3TX/WT3CCP1/PD3)
AIN5: J16.8, U5.63 (AIN5/SSI1RX/SSI3RX/WT3CCP0/PD2)
AIN6: J16.9, U5.62 (AIN6/I2C3SDA/SSI1FSS/SSI3FSS/WT2CCP1/PD1)
AIN7: J16.10, U5.61 (AIN7/I2C3SCL/SSI1CLK/SSI3CLK/WT2CCP0/PD0)
BOARD_ID: R92.2, U5.47 (I2C0SCL/T3CCP0/PB2)
EFFECT: U5.10 (NMI/U2TX/WT5CCP1/PD7); also elsewhere on the board
GND: C2.2, C3.2, C4.2, C5.2, C6.2, C9.2, C11.2, C12.2, C14.2, C15.2, C17.2, C18.2, C19.2, C21.2, C23.2, C26.2, C27.2, C28.2, D15.1 (K), J3.3, J5.3, J7.3, J7.5, J7.9, J8.5 (GND), J8.6 (Shield), J15.2, J16.11, J16.12, R56.2, R58.2, R60.2, SW6.1, SW6.2, U5.3 (GNDA), U5.12 (GND), U5.27 (GND), U5.39 (GND), U5.55 (GND), U6.2 (GND), U7.1 (GND), U7.2 (GND), U7.3 (GND), U7.7 (GND); also elsewhere on the board
I2C_SCL: U5.23 (I2C1SCL/PA6); also elsewhere on the board
I2C_SDA: U5.24 (I2C1SDA/PA7); also elsewhere on the board
JTAG_RST_N: J7.10, JP2.1
JTAG_TCK: J7.4, R87.2, U5.52 (TCK/SWCLK/T4CCP0/PC0)
JTAG_TDI: J7.8, U5.50 (TDI/T5CCP0/PC2)
JTAG_TDO: J7.6, U5.49 (TDO/SWO/T5CCP1/PC3)
JTAG_TMS: J7.2, R88.2, U5.51 (TMS/SWDIO/T4CCP1/PC1)
LED0: U5.19 (SSI0CLK/PA2); also elsewhere on the board
LED1: U5.28 (PF0/T0CCP0/SSI1RX/U1RTS/CAN0RX/C0O/MNI); also elsewhere on the board
LED2: U5.30 (PF2/T1CCP0/SSI1CLK/TRD0); also elsewhere on the board
LED3: U5.57 (AIN11/CAN0TX/SSI2FSS/T1CCP1/PB5); also elsewhere on the board
LED4: U5.60 (PE5/AIN8/U5TX/I2C2SDA/CAN0TX); also elsewhere on the board
LED5: U5.5 (PF4/T2CCP0); also elsewhere on the board
LED6: U5.4 (SSI2TX/T0CCP1/PB7); also elsewhere on the board
LED7: U5.1 (SSI2RX/T0CCP0/PB6); also elsewhere on the board
LOOP0: U5.22 (SSI0TX/PA5); also elsewhere on the board
LOOP1: U5.21 (SSI0RX/PA4); also elsewhere on the board
LOOP2: U5.20 (SSI0FSS/PA3); also elsewhere on the board
LOOP3: U5.14 (C0+/U3RX/WT1CCP0/PC6); also elsewhere on the board
LOOP4: U5.13 (C0-/U3TX/WT1CCP1/PC7); also elsewhere on the board
LOOP5: U5.48 (I2C0SDA/T3CCP1/PB3); also elsewhere on the board
LOOP6: U5.53 (U2RX/WT5CCP0/PD6); also elsewhere on the board
LOOP7: U5.58 (AIN10/CAN0RX/SSI2CLK/T1CCP0/PB4); also elsewhere on the board
unnamed: C26.1, U6.4 (NR)
unnamed: C28.1, JP1.1, R91.2, SW6.3, SW6.4
unnamed: D13.1 (K), R58.1
unnamed: D14.1 (K), R60.1
unnamed: D15.2 (A), R76.2
unnamed: J8.4 (ID), R90.1
unnamed: R62.1, U5.41 (OSC1)
unnamed: R93.1, U5.37 (VBAT)
unnamed: TP2.1, U5.33 (~HIB~)
PE4: J15.1, U5.59 (PE4/AIN9/U5RX/I2C2SCL/CAN0RX)
RST_N: JP1.2, JP2.2, U5.38 (~RST~)
UART0_RX: J3.1, U5.17 (U0RX/PA0)
UART0_TX: J3.2, U5.18 (U0TX/PA1)
UART1_RX: J5.1, U5.16 (C1-/U1RTS/U1RX/U4RX/WT0CCP0/PC4)
UART1_TX: J5.2, U5.15 (C1+/U1CTS/U1TX/U4TX/WT0CCP1/PC5)
USB_D+: J8.3 (D+), U5.44 (U6TX/WT4CCP1/PD5)
USB_D-: J8.2 (D-), U5.43 (U6RX/WT4CCP0/PD4)
USB_ID: R90.2, U5.45 (U1RX/T2CCP0/PB0)
USB_VBUS: R89.2, U5.46 (U1TX/T2CCP1/PB1)
VBUS: C27.1, FB2.2, J8.1 (VBUS), R89.1, TP16.1, U6.1 (IN), U6.3 (EN), U7.4 (IN), U7.5 (IN), U7.6 (IN)
VDDC: C5.1, C9.1, C11.1, C12.1, U5.25 (VDDC), U5.56 (VDDC)

Notes on the sheet:
Filtered 5V for Blue LED
JTAG
Power Supply
USB Connector
RESET
Looper Board ID : 1
Debug UART0
Debug UART1
PAD 10K POT
SPARE I/O

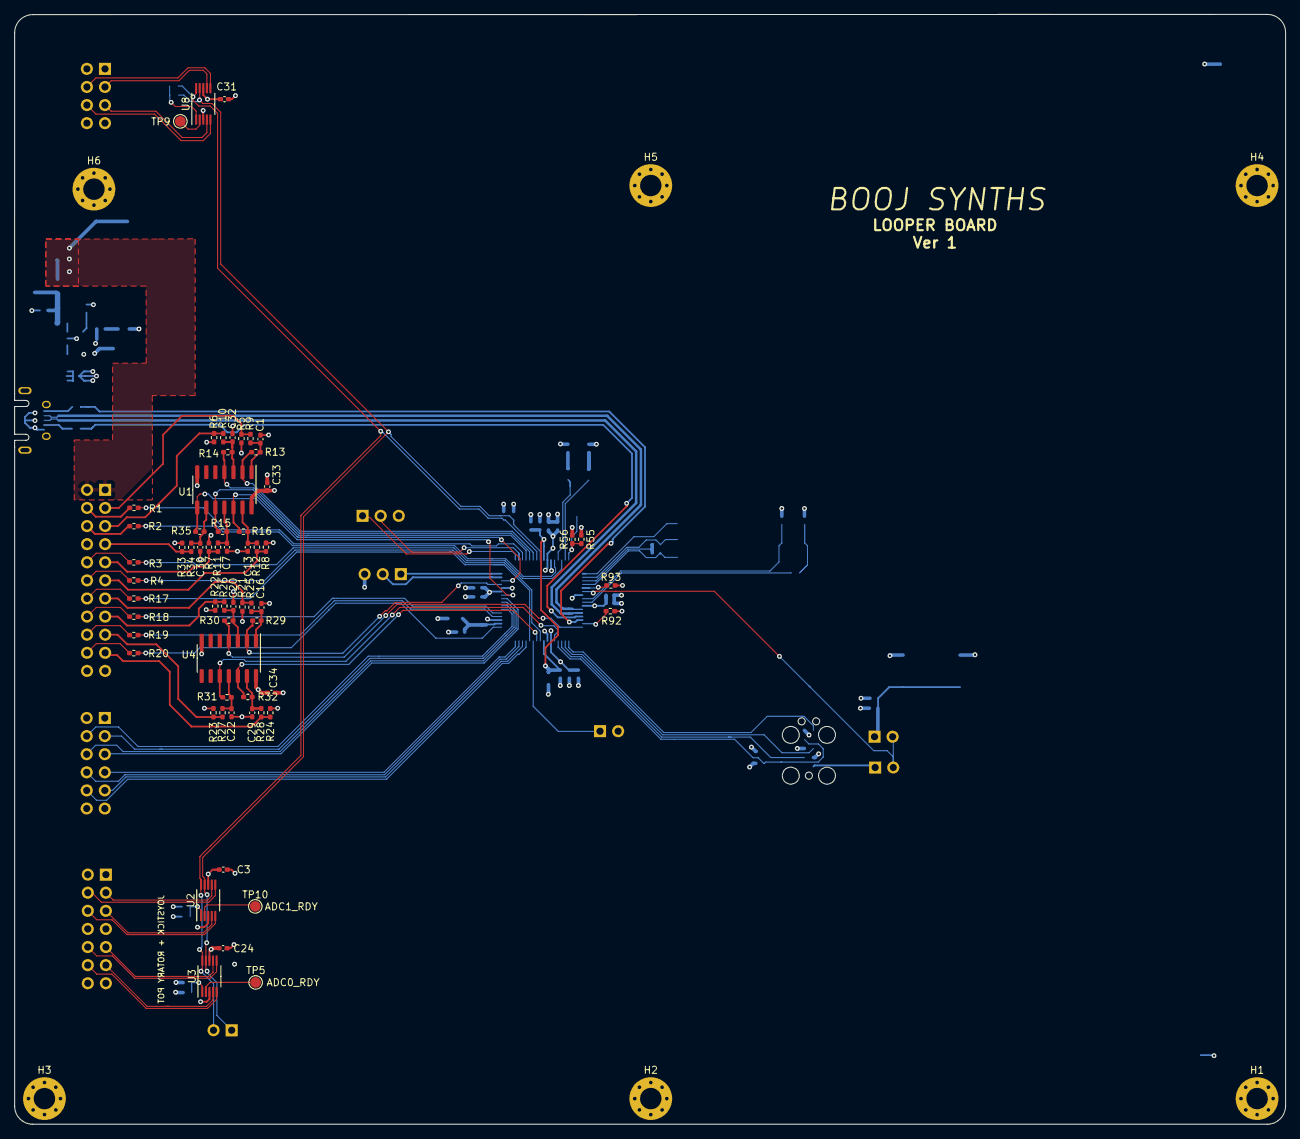
[picture p15: board Looper_Board.kicad_pcb from above]

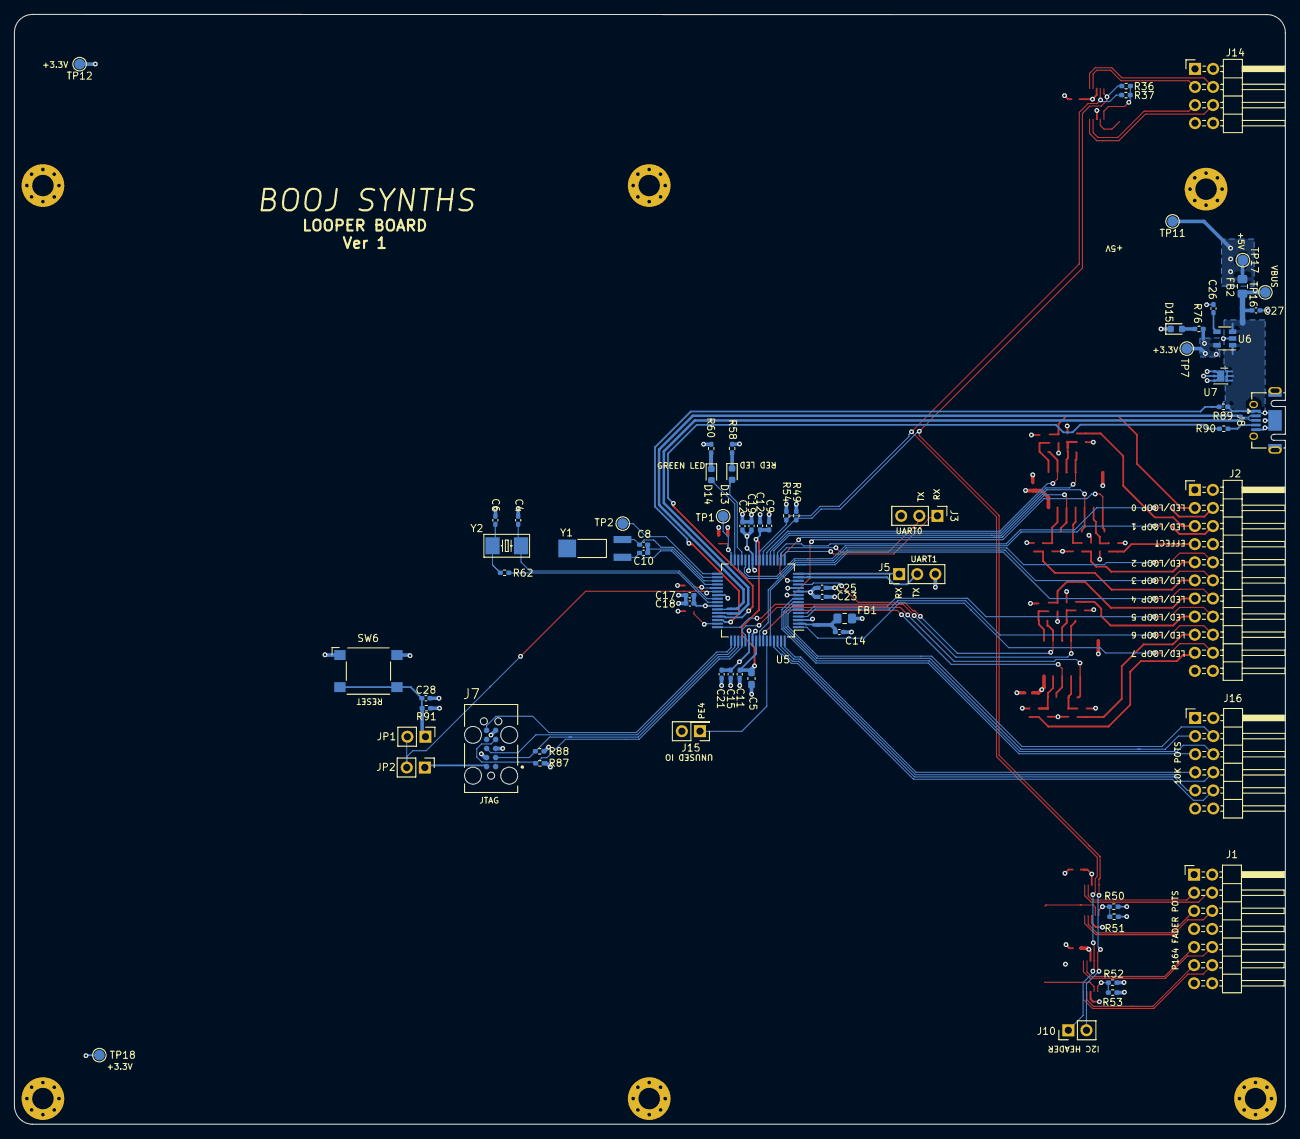
[picture p16: board Looper_Board.kicad_pcb from below]

Board: 4 copper layers, 178.3 x 155.7 mm, 135 parts (68 on the bottom side), 110 nets.

Other parts of the board:
TP17: +5V; TestPoint_Pad_D1.5mm
TP18: +3.3V; TestPoint_Pad_D1.5mm

Their connections:
+3V3: TP18.1; also elsewhere on the board
+5V: TP17.1; also elsewhere on the board
