bouge13a/pd_midi_synth/hardware/MIDI_Board/LED_Board/LED_Board.kicad_pcb

## KiCad design hardware/MIDI_Board/LED_Board/LED_Board.kicad_pcb (2022-02-10)

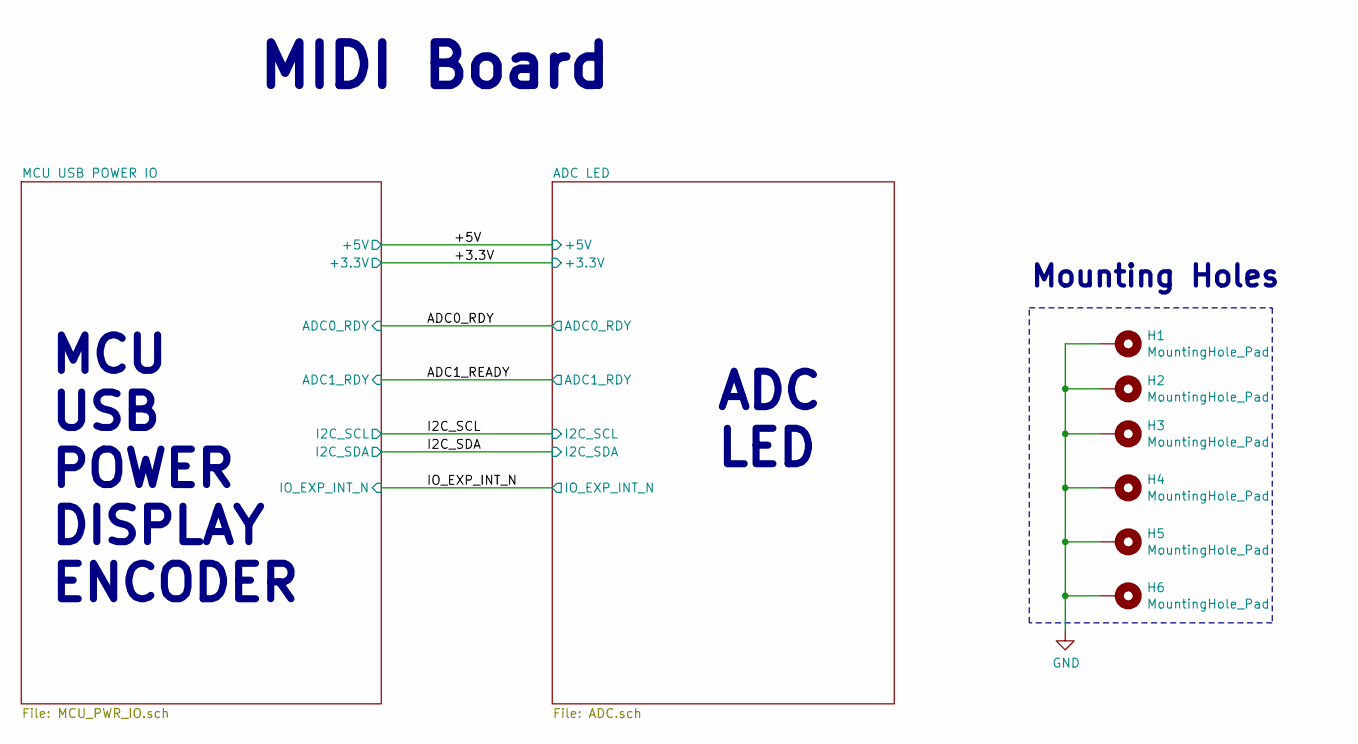
[picture p17: schematic LED_Board.sch, Board_TOP]

Parts:
H1, H2, H3, H4, H5, H6: MountingHole_Pad; MountingHole_3mm_Pad_Via

Connections:
GND: H1.1, H2.1, H3.1, H4.1, H5.1, H6.1; also elsewhere on the board

Notes on the sheet:
MIDI Board
MCU USB POWER DISPLAY ENCODER
ADC LED
Mounting Holes
