bouge13a/pd_midi_synth/hardware/MIDI_Board/LED_Board/LED_Board.kicad_pcb

## KiCad design hardware/MIDI_Board/LED_Board/LED_Board.kicad_pcb (continued)

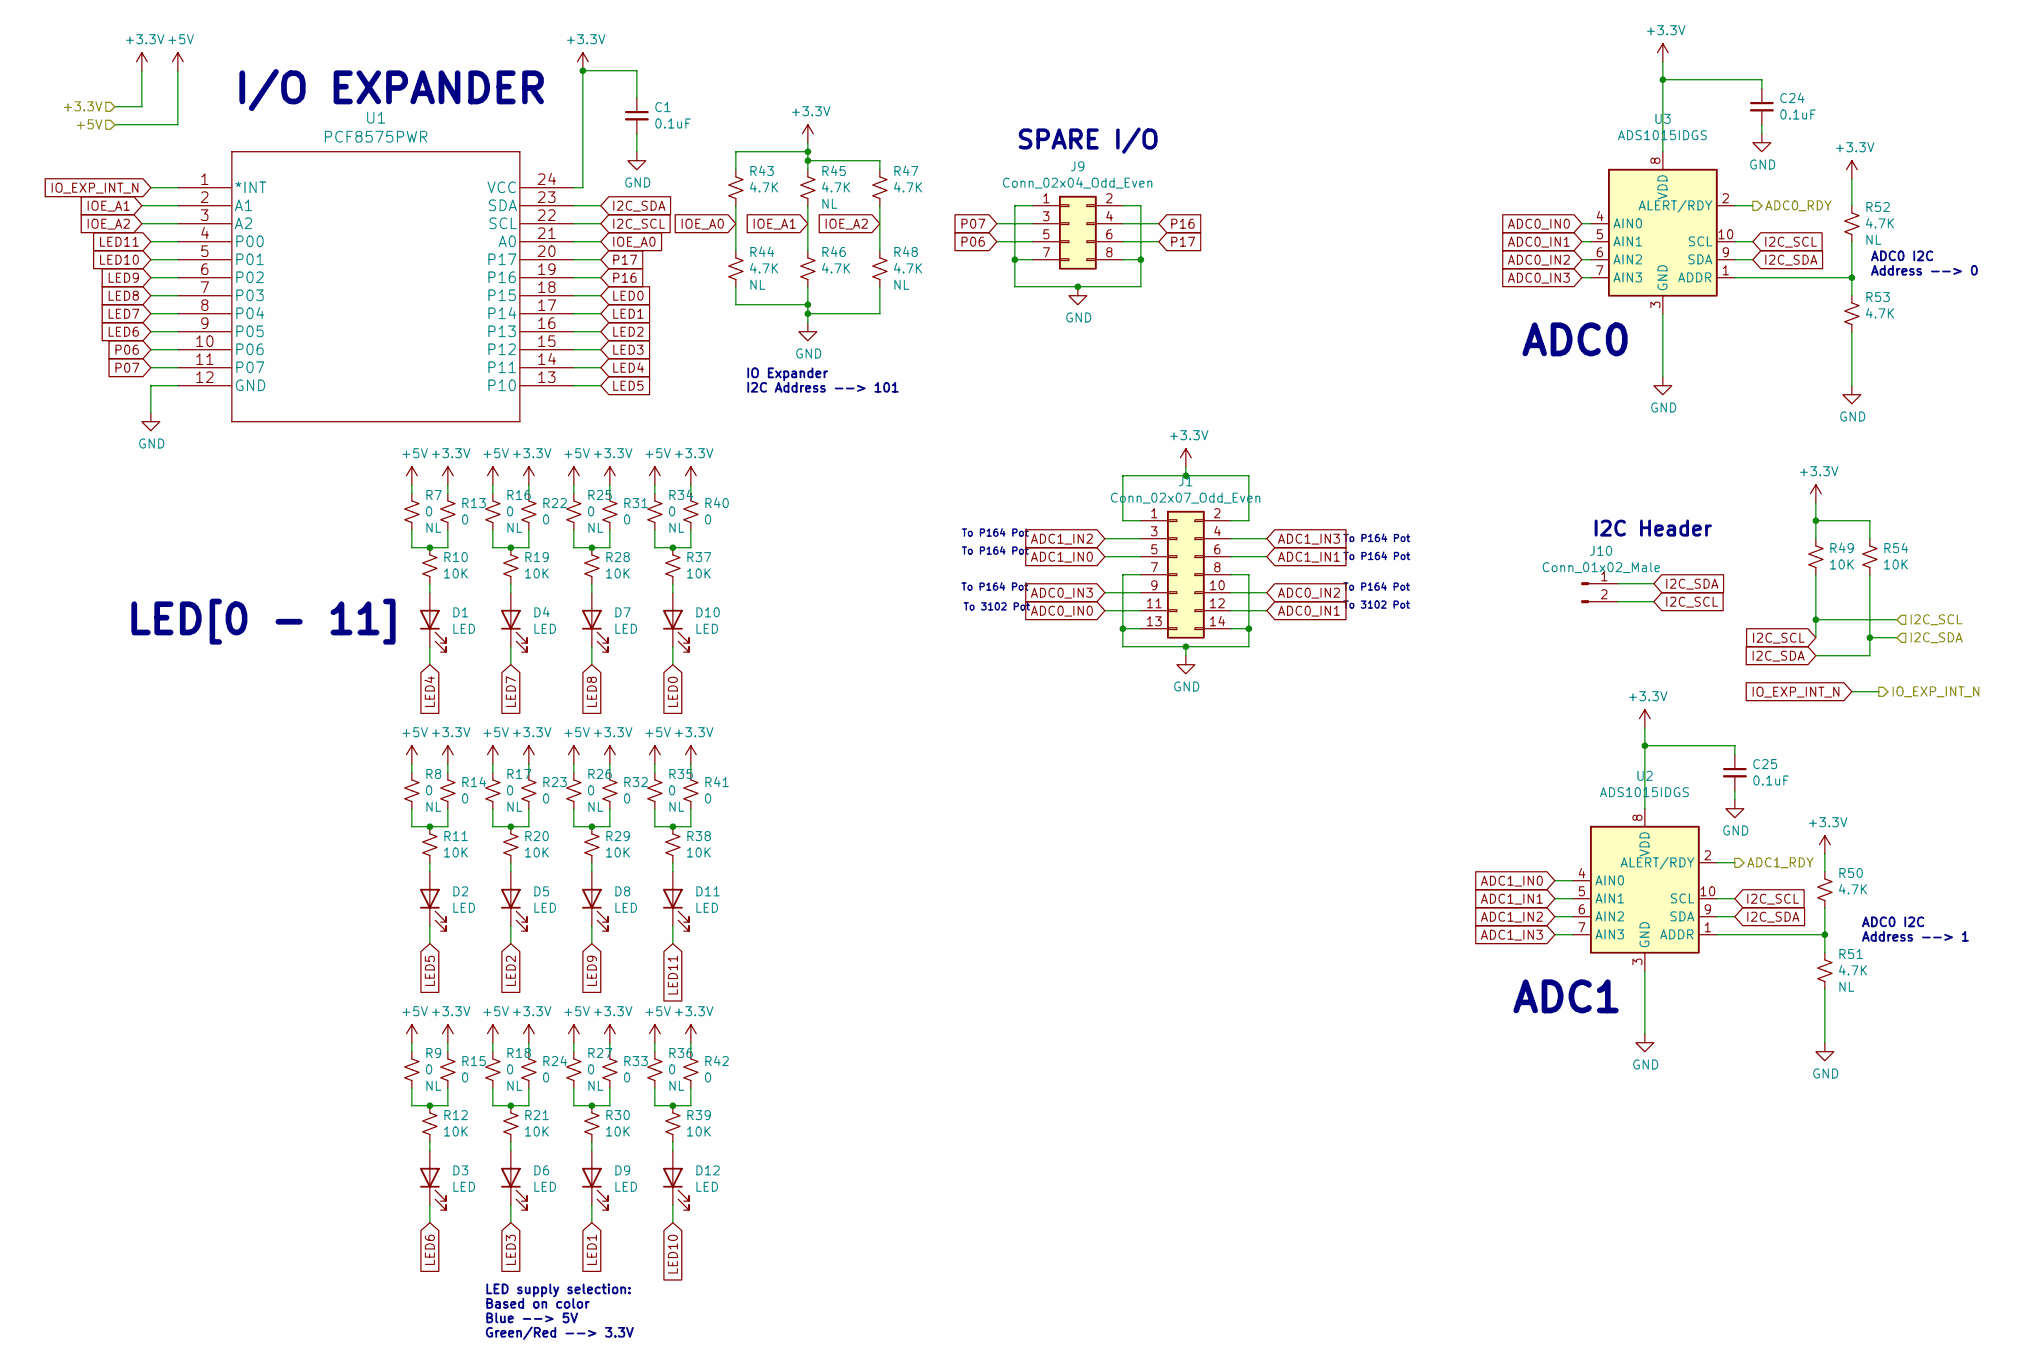
[picture p18: schematic ADC.sch, LED Board]

Parts:
C1, C24, C25: 0.1uF; C_0402_1005Metric_Pad0.74x0.62mm_HandSolder
D1, D2, D3, D4, D5, D6, D7, D8, D9, D10, D11, D12: LED; LED_D5.0mm
J1: Conn_02x07_Odd_Even; PinHeader_2x07_P2.54mm_Horizontal
J9: Conn_02x04_Odd_Even; PinHeader_2x04_P2.54mm_Vertical
J10: Conn_01x02_Male; PinHeader_1x02_P2.54mm_Vertical
R7, R8, R9, R13, R14, R15, R16, R17, R18, R22, R23, R24, R25, R26, R27, R31, R32, R33, R34, R35, R36, R40, R41, R42: 0; R_0402_1005Metric_Pad0.72x0.64mm_HandSolder
R10, R11, R12, R19, R20, R21, R28, R29, R30, R37, R38, R39, R49, R54: 10K; R_0402_1005Metric_Pad0.72x0.64mm_HandSolder
R43, R44, R45, R46, R47, R48, R50, R51, R52, R53: 4.7K; R_0402_1005Metric_Pad0.72x0.64mm_HandSolder
U1: PCF8575PWR; SOIC-24W_7.5x15.4mm_P1.27mm
U2, U3: ADS1015IDGS; VSSOP-10_3x3mm_P0.5mm

Connections:
+3V3: C1.1, C24.1, C25.1, J1.1, J1.2, R13.1, R14.1, R15.1, R22.1, R23.1, R24.1, R31.1, R32.1, R33.1, R40.1, R41.1, R42.1, R43.1, R45.1, R47.1, R49.1, R50.1, R52.1, R54.1, U1.24 (VCC), U2.8 (VDD), U3.8 (VDD); also elsewhere on the board
+5V: R7.1, R8.1, R9.1, R16.1, R17.1, R18.1, R25.1, R26.1, R27.1, R34.1, R35.1, R36.1; also elsewhere on the board
ADC0_IN0: J1.11, U3.4 (AIN0)
ADC0_IN1: J1.12, U3.5 (AIN1)
ADC0_IN2: J1.10, U3.6 (AIN2)
ADC0_IN3: J1.9, U3.7 (AIN3)
ADC0_RDY: U3.2 (ALERT/RDY); also elsewhere on the board
ADC1_IN0: J1.5, U2.4 (AIN0)
ADC1_IN1: J1.6, U2.5 (AIN1)
ADC1_IN2: J1.3, U2.6 (AIN2)
ADC1_IN3: J1.4, U2.7 (AIN3)
ADC1_RDY: U2.2 (ALERT/RDY); also elsewhere on the board
GND: C1.2, C24.2, C25.2, J1.7, J1.8, J1.13, J1.14, J9.1, J9.2, J9.7, J9.8, R44.2, R46.2, R48.2, R51.2, R53.2, U1.12 (GND), U2.3 (GND), U3.3 (GND); also elsewhere on the board
I2C_SCL: J10.2, R49.2, U1.22 (SCL), U2.10 (SCL), U3.10 (SCL); also elsewhere on the board
I2C_SDA: J10.1, R54.2, U1.23 (SDA), U2.9 (SDA), U3.9 (SDA); also elsewhere on the board
IOE_A0: R43.2, R44.1, U1.21 (A0)
IOE_A1: R45.2, R46.1, U1.2 (A1)
IOE_A2: R47.2, R48.1, U1.3 (A2)
IO_EXP_INT_N: U1.1 (*INT); also elsewhere on the board
LED0: D10.1 (K), U1.18 (P15)
LED1: D9.1 (K), U1.17 (P14)
LED2: D5.1 (K), U1.16 (P13)
LED3: D6.1 (K), U1.15 (P12)
LED4: D1.1 (K), U1.14 (P11)
LED5: D2.1 (K), U1.13 (P10)
LED6: D3.1 (K), U1.9 (P05)
LED7: D4.1 (K), U1.8 (P04)
LED8: D7.1 (K), U1.7 (P03)
LED9: D8.1 (K), U1.6 (P02)
LED10: D12.1 (K), U1.5 (P01)
LED11: D11.1 (K), U1.4 (P00)
unnamed: D1.2 (A), R10.2
unnamed: D2.2 (A), R11.2
unnamed: D3.2 (A), R12.2
unnamed: D4.2 (A), R19.2
unnamed: D5.2 (A), R20.2
unnamed: D6.2 (A), R21.2
unnamed: D7.2 (A), R28.2
unnamed: D8.2 (A), R29.2
unnamed: D9.2 (A), R30.2
unnamed: D10.2 (A), R37.2
unnamed: D11.2 (A), R38.2
unnamed: D12.2 (A), R39.2
unnamed: R7.2, R10.1, R13.2
unnamed: R8.2, R11.1, R14.2
unnamed: R9.2, R12.1, R15.2
unnamed: R16.2, R19.1, R22.2
unnamed: R17.2, R20.1, R23.2
unnamed: R18.2, R21.1, R24.2
unnamed: R25.2, R28.1, R31.2
unnamed: R26.2, R29.1, R32.2
unnamed: R27.2, R30.1, R33.2
unnamed: R34.2, R37.1, R40.2
unnamed: R35.2, R38.1, R41.2
unnamed: R36.2, R39.1, R42.2
unnamed: R50.2, R51.1, U2.1 (ADDR)
unnamed: R52.2, R53.1, U3.1 (ADDR)
P06: J9.5, U1.10 (P06)
P07: J9.3, U1.11 (P07)
P16: J9.4, U1.19 (P16)
P17: J9.6, U1.20 (P17)

Notes on the sheet:
To 3102 Pot
LED supply selection: Based on color Blue --> 5V Green/Red --> 3.3V
I/O EXPANDER
ADC0
ADC1
LED[0 - 11]
ADC0 I2C Address --> 0
ADC0 I2C Address --> 1
IO Expander I2C Address --> 101
To P164 Pot
SPARE I/O
I2C Header

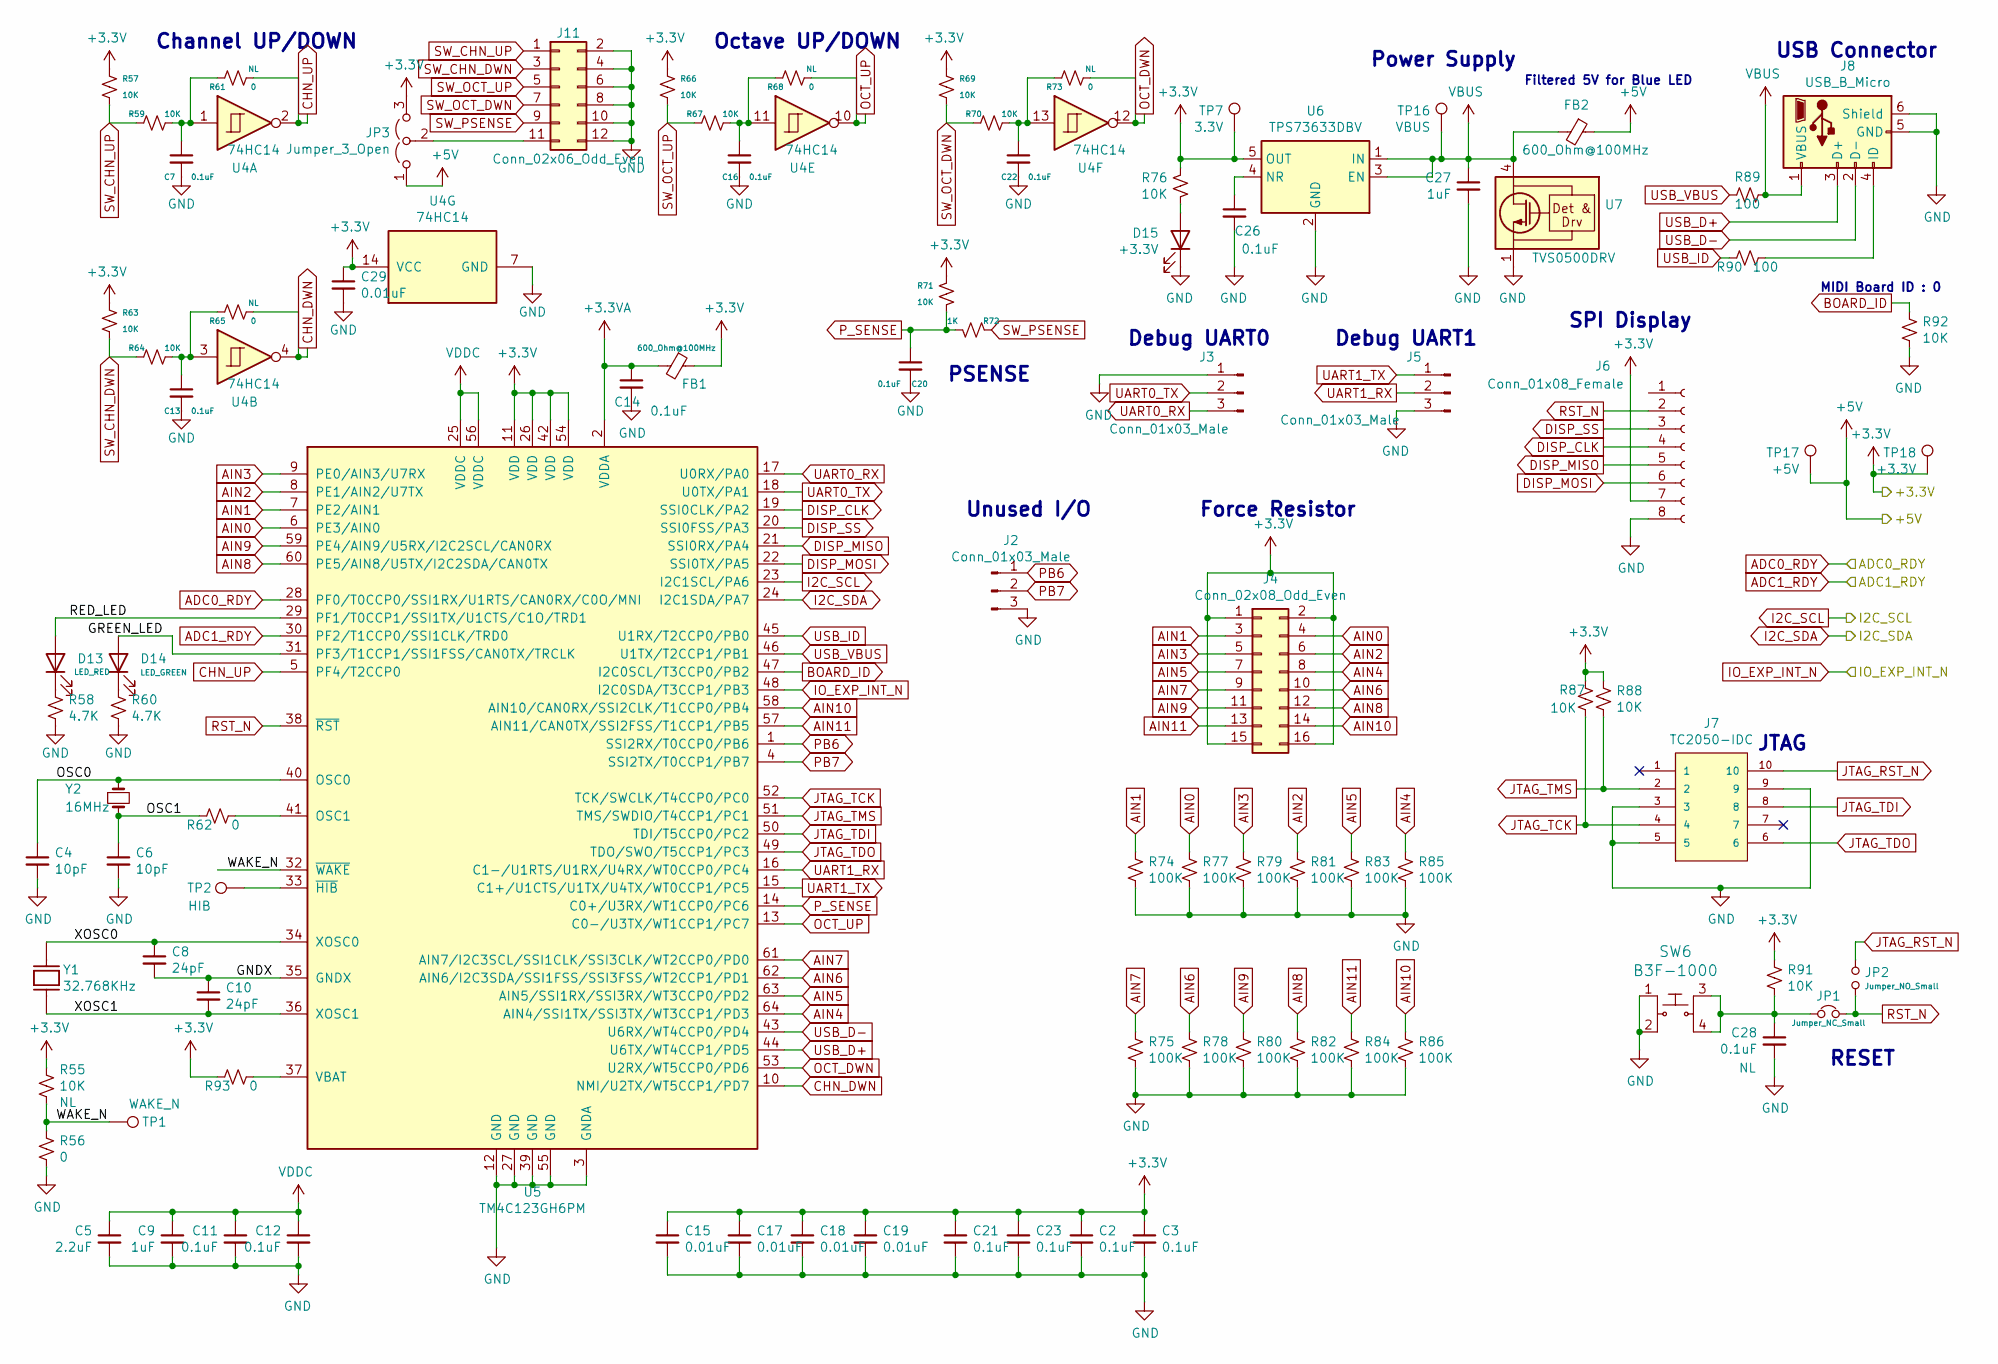
[picture p19: schematic MCU_PWR_IO.sch, MCU_PWR_USB]

Parts:
C2, C3, C7, C11, C12, C13, C14, C16, C20, C21, C22, C23, C26, C28: 0.1uF; C_0402_1005Metric_Pad0.74x0.62mm_HandSolder
C4, C6: 10pF; C_0402_1005Metric_Pad0.74x0.62mm_HandSolder
C5: 2.2uF; C_0603_1608Metric_Pad1.08x0.95mm_HandSolder; LCSCP# C23630
C8, C10: 24pF; C_0402_1005Metric_Pad0.74x0.62mm_HandSolder
C9, C27: 1uF; C_0402_1005Metric_Pad0.74x0.62mm_HandSolder
C15, C17, C18, C19, C29: 0.01uF; C_0402_1005Metric_Pad0.74x0.62mm_HandSolder
D13: LED_RED; LED_0603_1608Metric
D14: LED_GREEN; LED_0603_1608Metric
D15: +3.3V; LED_0603_1608Metric
FB1, FB2: 600_Ohm@100MHz; L_0805_2012Metric_Pad1.15x1.40mm_HandSolder; MfrPart GZ2012D601TF
J2, J3, J5: Conn_01x03_Male; PinHeader_1x03_P2.54mm_Vertical
J4: Conn_02x08_Odd_Even; PinHeader_2x08_P2.54mm_Horizontal
J6: Conn_01x08_Female; PinHeader_1x08_P2.54mm_Horizontal
J7: TC2050-IDC; TAG-CONNECT_TC2050-IDC; PARTREV A
J8: USB_B_Micro; USB_Micro-AB_Molex_47590-0001
J11: Conn_02x06_Odd_Even; PinHeader_2x06_P2.54mm_Horizontal
JP1: Jumper_NC_Small; PinHeader_1x02_P2.54mm_Vertical
JP2: Jumper_NO_Small; PinHeader_1x02_P2.54mm_Vertical
JP3: Jumper_3_Open; PinHeader_1x03_P2.54mm_Vertical
R55, R57, R59, R63, R64, R66, R67, R69, R70, R71, R76, R87, R88, R91, R92: 10K; R_0402_1005Metric_Pad0.72x0.64mm_HandSolder
R56, R61, R62, R65, R68, R73, R93: 0; R_0402_1005Metric_Pad0.72x0.64mm_HandSolder
R58, R60: 4.7K; R_0402_1005Metric_Pad0.72x0.64mm_HandSolder
R72: 1K; R_0402_1005Metric_Pad0.72x0.64mm_HandSolder
R74, R75, R77, R78, R79, R80, R81, R82, R83, R84, R85, R86: 100K; R_0402_1005Metric_Pad0.72x0.64mm_HandSolder
R89, R90: 100; R_0402_1005Metric_Pad0.72x0.64mm_HandSolder
SW6: B3F-1000; SW_SPST_Omron_B3FS-100xP; MPN B3F-1000; Digi-Key_PN SW400-ND
TP1: WAKE_N; TestPoint_Pad_D1.5mm
TP2: HIB; TestPoint_Pad_D1.5mm
TP7: 3.3V; TestPoint_Pad_D1.5mm
TP16: VBUS; TestPoint_Pad_D1.5mm
TP17: +5V; TestPoint_Pad_D1.5mm
TP18: +3.3V; TestPoint_Pad_D1.5mm
U4: 74HC14; SOIC-14_3.9x8.7mm_P1.27mm
U5: TM4C123GH6PM; LQFP-64_10x10mm_P0.5mm
U6: TPS73633DBV; SOT-23-5
U7: TVS0500DRV; WSON-6-1EP_2x2mm_P0.65mm_EP1x1.6mm
Y1: 32.768KHz; XTAL_AB26TRB-32.768KHZ-T
Y2: 16MHz; CRYSTAL_5_3.2MM

Connections:
+3.3VA: C14.1, FB1.2, U5.2 (VDDA)
+3V3: C2.1, C3.1, C15.1, C17.1, C18.1, C19.1, C21.1, C23.1, C29.1, FB1.1, J4.1, J4.2, J4.15, J4.16, J6.7, JP3.3 (B), R55.1, R57.1, R63.1, R66.1, R69.1, R71.1, R76.1, R87.1, R88.1, R91.1, R93.2, TP7.1, TP18.1, U4.14 (VCC), U5.11 (VDD), U5.26 (VDD), U5.42 (VDD), U5.54 (VDD), U6.5 (OUT); also elsewhere on the board
+5V: FB2.1, JP3.1 (A), TP17.1; also elsewhere on the board
/MCU USB POWER IO/GNDX: C8.2, C10.1, U5.35 (GNDX)
/MCU USB POWER IO/GREEN_LED: D14.2 (A), U5.31 (PF3/T1CCP1/SSI1FSS/CAN0TX/TRCLK)
/MCU USB POWER IO/OSC0: C4.1, U5.40 (OSC0), Y2.1
/MCU USB POWER IO/OSC1: C6.1, R62.2, Y2.2
/MCU USB POWER IO/RED_LED: D13.2 (A), U5.29 (PF1/T0CCP1/SSI1TX/U1CTS/C1O/TRD1)
/MCU USB POWER IO/WAKE_N: R55.2, R56.1, TP1.1, U5.32 (~WAKE~)
/MCU USB POWER IO/XOSC0: C8.1, U5.34 (XOSC0), Y1.1
/MCU USB POWER IO/XOSC1: C10.2, U5.36 (XOSC1), Y1.2
ADC0_RDY: U5.28 (PF0/T0CCP0/SSI1RX/U1RTS/CAN0RX/C0O/MNI); also elsewhere on the board
ADC1_RDY: U5.30 (PF2/T1CCP0/SSI1CLK/TRD0); also elsewhere on the board
AIN0: J4.4, R77.1, U5.6 (PE3/AIN0)
AIN1: J4.3, R74.1, U5.7 (PE2/AIN1)
AIN2: J4.6, R81.1, U5.8 (PE1/AIN2/U7TX)
AIN3: J4.5, R79.1, U5.9 (PE0/AIN3/U7RX)
AIN4: J4.8, R85.1, U5.64 (AIN4/SSI1TX/SSI3TX/WT3CCP1/PD3)
AIN5: J4.7, R83.1, U5.63 (AIN5/SSI1RX/SSI3RX/WT3CCP0/PD2)
AIN6: J4.10, R78.1, U5.62 (AIN6/I2C3SDA/SSI1FSS/SSI3FSS/WT2CCP1/PD1)
AIN7: J4.9, R75.1, U5.61 (AIN7/I2C3SCL/SSI1CLK/SSI3CLK/WT2CCP0/PD0)
AIN8: J4.12, R82.1, U5.60 (PE5/AIN8/U5TX/I2C2SDA/CAN0TX)
AIN9: J4.11, R80.1, U5.59 (PE4/AIN9/U5RX/I2C2SCL/CAN0RX)
AIN10: J4.14, R86.1, U5.58 (AIN10/CAN0RX/SSI2CLK/T1CCP0/PB4)
AIN11: J4.13, R84.1, U5.57 (AIN11/CAN0TX/SSI2FSS/T1CCP1/PB5)
BOARD_ID: R92.1, U5.47 (I2C0SCL/T3CCP0/PB2)
CHN_DWN: R65.1, U4.4, U5.10 (NMI/U2TX/WT5CCP1/PD7)
CHN_UP: R61.1, U4.2, U5.5 (PF4/T2CCP0)
DISP_CLK: J6.4, U5.19 (SSI0CLK/PA2)
DISP_MISO: J6.5, U5.21 (SSI0RX/PA4)
DISP_MOSI: J6.6, U5.22 (SSI0TX/PA5)
DISP_SS: J6.3, U5.20 (SSI0FSS/PA3)
GND: C2.2, C3.2, C4.2, C5.2, C6.2, C7.2, C9.2, C11.2, C12.2, C13.2, C14.2, C15.2, C16.2, C17.2, C18.2, C19.2, C20.2, C21.2, C22.2, C23.2, C26.2, C27.2, C28.2, C29.2, D15.1 (K), J2.3, J3.1, J5.3, J6.8, J7.3, J7.5, J7.9, J8.5 (GND), J8.6 (Shield), J11.2, J11.4, J11.6, J11.8, J11.10, J11.12, R56.2, R58.2, R60.2, R74.2, R75.2, R77.2, R78.2, R79.2, R80.2, R81.2, R82.2, R83.2, R84.2, R85.2, R86.2, R92.2, SW6.1, SW6.2, U4.7 (GND), U5.3 (GNDA), U5.12 (GND), U5.27 (GND), U5.39 (GND), U5.55 (GND), U6.2 (GND), U7.1 (GND), U7.2 (GND), U7.3 (GND), U7.7 (GND); also elsewhere on the board
I2C_SCL: U5.23 (I2C1SCL/PA6); also elsewhere on the board
I2C_SDA: U5.24 (I2C1SDA/PA7); also elsewhere on the board
IO_EXP_INT_N: U5.48 (I2C0SDA/T3CCP1/PB3); also elsewhere on the board
JTAG_RST_N: J7.10, JP2.1
JTAG_TCK: J7.4, R87.2, U5.52 (TCK/SWCLK/T4CCP0/PC0)
JTAG_TDI: J7.8, U5.50 (TDI/T5CCP0/PC2)
JTAG_TDO: J7.6, U5.49 (TDO/SWO/T5CCP1/PC3)
JTAG_TMS: J7.2, R88.2, U5.51 (TMS/SWDIO/T4CCP1/PC1)
unnamed: C7.1, R59.2, R61.2, U4.1
unnamed: C13.1, R64.2, R65.2, U4.3
unnamed: C16.1, R67.2, R68.2, U4.11
unnamed: C22.1, R70.2, R73.2, U4.13
unnamed: C26.1, U6.4 (NR)
unnamed: C28.1, JP1.1, R91.2, SW6.3, SW6.4
unnamed: D13.1 (K), R58.1
unnamed: D14.1 (K), R60.1
unnamed: D15.2 (A), R76.2
unnamed: J8.4 (ID), R90.1
unnamed: J11.11, JP3.2 (C)
unnamed: R62.1, U5.41 (OSC1)
unnamed: R93.1, U5.37 (VBAT)
unnamed: TP2.1, U5.33 (~HIB~)
OCT_DWN: R73.1, U4.12, U5.53 (U2RX/WT5CCP0/PD6)
OCT_UP: R68.1, U4.10, U5.13 (C0-/U3TX/WT1CCP1/PC7)
PB6: J2.1, U5.1 (SSI2RX/T0CCP0/PB6)
PB7: J2.2, U5.4 (SSI2TX/T0CCP1/PB7)
P_SENSE: C20.1, R71.2, R72.2, U5.14 (C0+/U3RX/WT1CCP0/PC6)
RST_N: J6.2, JP1.2, JP2.2, U5.38 (~RST~)
SW_CHN_DWN: J11.3, R63.2, R64.1
SW_CHN_UP: J11.1, R57.2, R59.1
SW_OCT_DWN: J11.7, R69.2, R70.1
SW_OCT_UP: J11.5, R66.2, R67.1
SW_PSENSE: J11.9, R72.1
UART0_RX: J3.3, U5.17 (U0RX/PA0)
UART0_TX: J3.2, U5.18 (U0TX/PA1)
UART1_RX: J5.2, U5.16 (C1-/U1RTS/U1RX/U4RX/WT0CCP0/PC4)
UART1_TX: J5.1, U5.15 (C1+/U1CTS/U1TX/U4TX/WT0CCP1/PC5)
USB_D+: J8.3 (D+), U5.44 (U6TX/WT4CCP1/PD5)
USB_D-: J8.2 (D-), U5.43 (U6RX/WT4CCP0/PD4)
USB_ID: R90.2, U5.45 (U1RX/T2CCP0/PB0)
USB_VBUS: R89.2, U5.46 (U1TX/T2CCP1/PB1)
VBUS: C27.1, FB2.2, J8.1 (VBUS), R89.1, TP16.1, U6.1 (IN), U6.3 (EN), U7.4 (IN), U7.5 (IN), U7.6 (IN)
VDDC: C5.1, C9.1, C11.1, C12.1, U5.25 (VDDC), U5.56 (VDDC)

Notes on the sheet:
Filtered 5V for Blue LED
Force Resistor
JTAG
Unused I/O
Power Supply
USB Connector
RESET
SPI Display
MIDI Board ID : 0
Debug UART0
Debug UART1
Octave UP/DOWN
PSENSE
Channel UP/DOWN

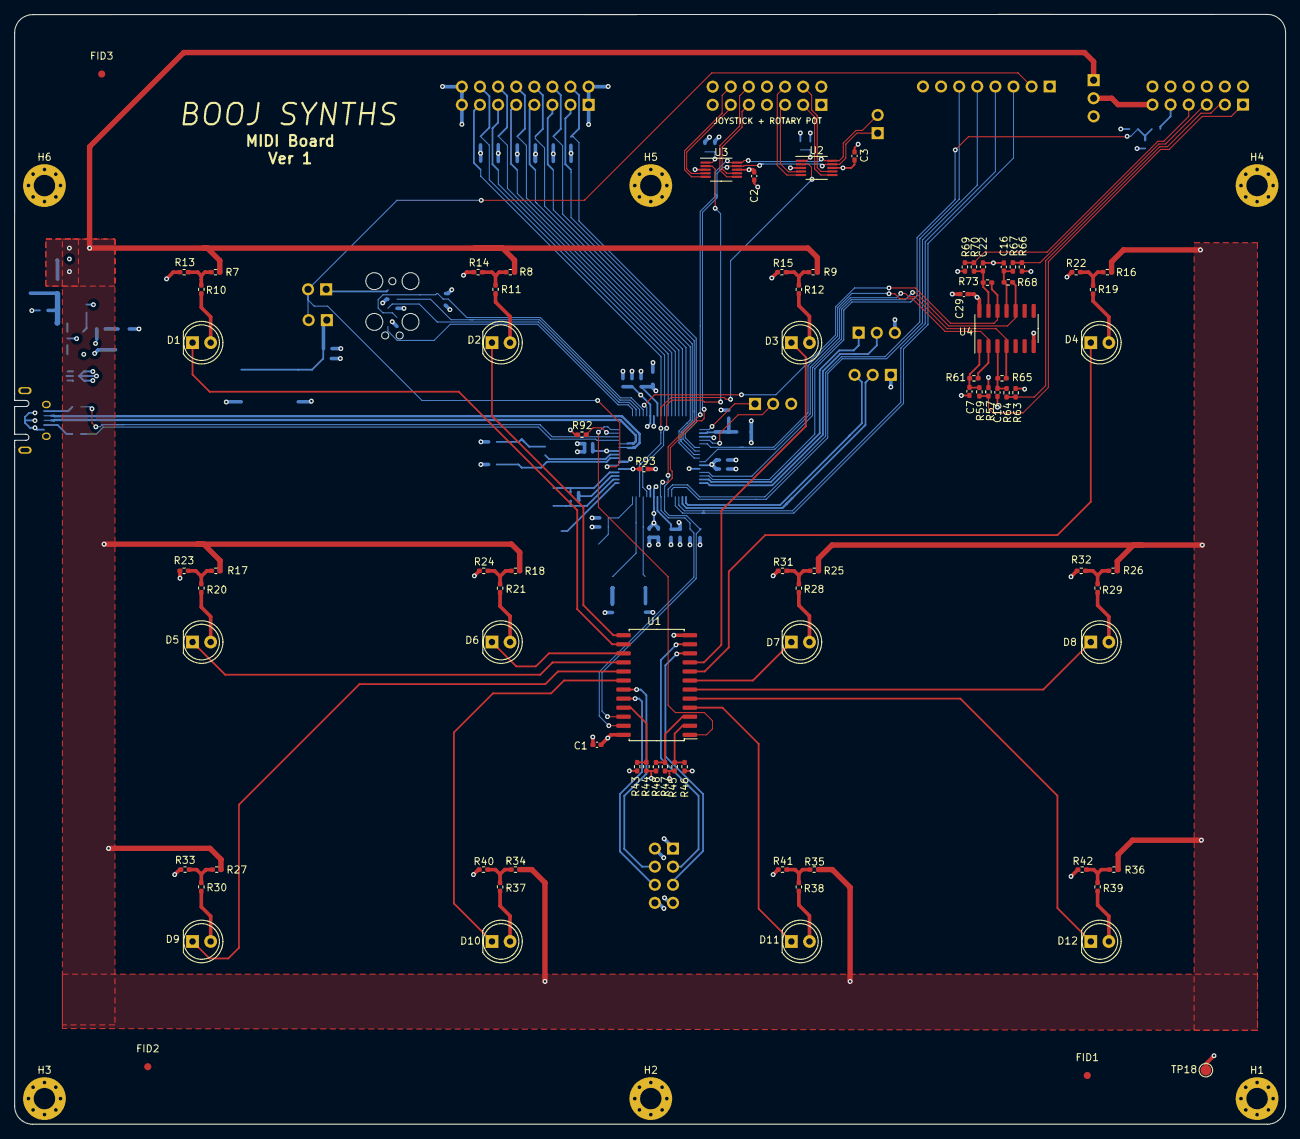
[picture p20: board LED_Board.kicad_pcb from above]

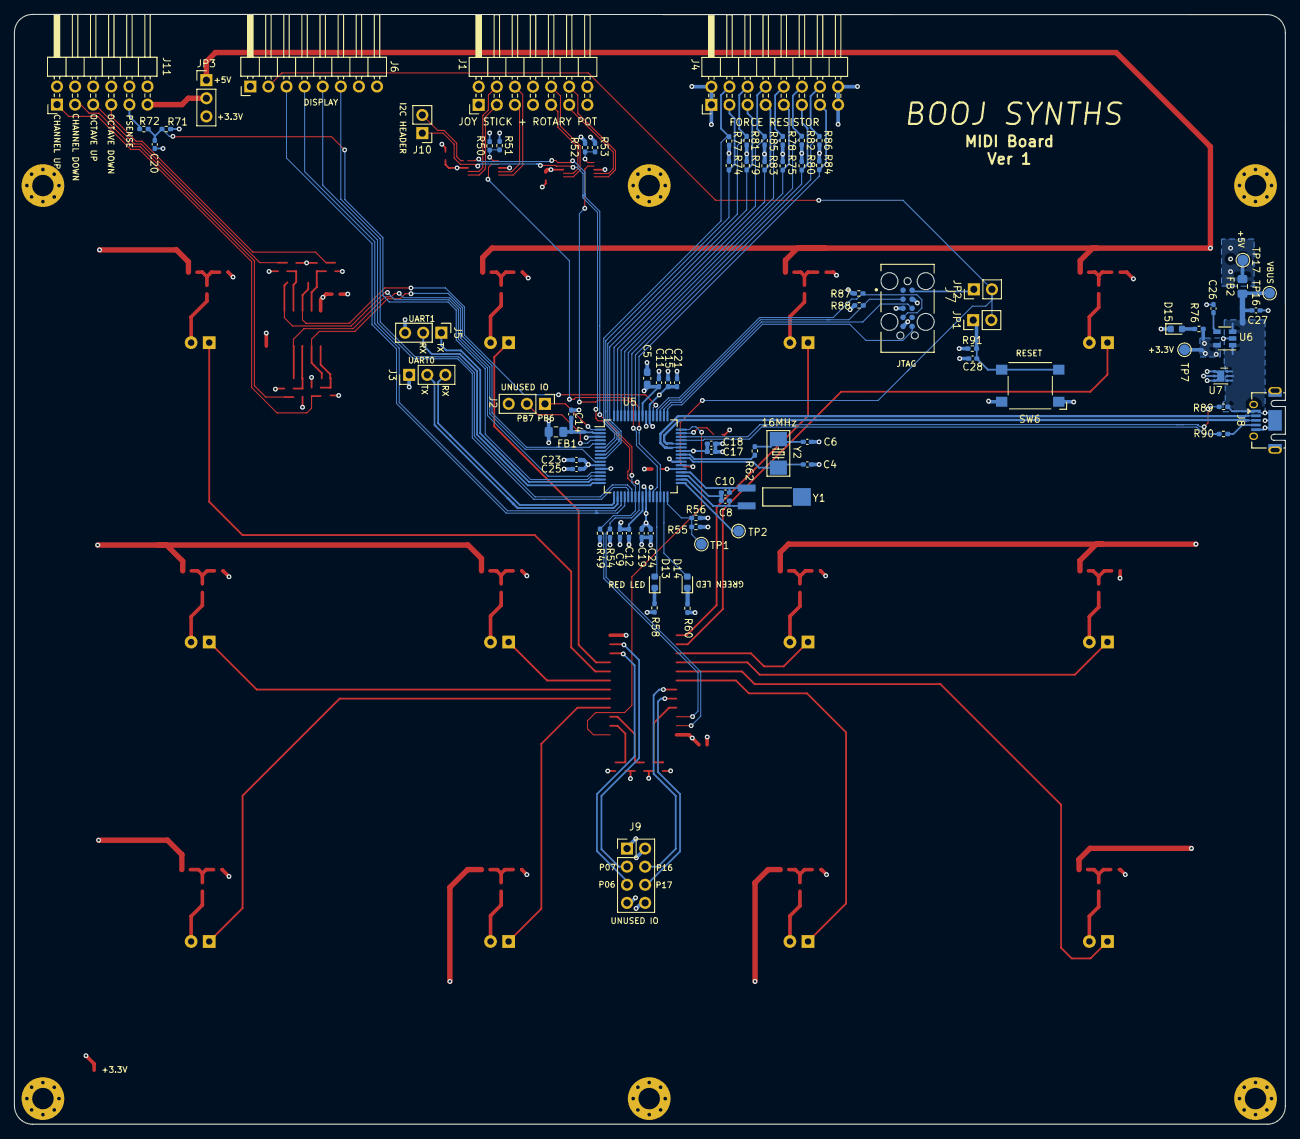
[picture p21: board LED_Board.kicad_pcb from below]

Board: 4 copper layers, 178.3 x 155.7 mm, 172 parts (82 on the bottom side), 129 nets.

Other parts of the board:
FID1, FID2, FID3: Fiducial_1mm_Mask3mm
