bouge13a/pd_midi_synth/midi_ctrl_board.h

/*
 * midi_ctrl_board.h
 *
 *  Created on: Apr 11, 2021
 *      Author: steph
 */

#ifndef MIDI_CTRL_BOARD_H_
#define MIDI_CTRL_BOARD_H_

void init_midi_ctrl_board(void);

#endif /* MIDI_CTRL_BOARD_H_ */
