bouge13a/pd_midi_synth/control_page.h

/*
 * control_page.h
 *
 *  Created on: Aug 5, 2020
 *      Author: steph
 */

#ifndef CONTROL_PAGE_H_
#define CONTROL_PAGE_H_

void control_drawpage(void);
void control_drawdata(void);
void control_drawinput(int character);

#endif /* CONTROL_PAGE_H_ */
