bouge13a/pd_midi_synth/ads1x15_task.c

/*
 * joystick_task.c
 *
 *  Created on: Apr 10, 2021
 *      Author: steph
 */

#include <stdint.h>
#include <uartstdio.h>

#include "FreeRTOS.h"
#include "task.h"

#include "text_controls.h"
#include "ads1x15_task.h"
#include "I2C_task.h"
//#include "host_uart_task.h"
#include "midi_channel_select.h"
#include "joystick_functions.h"
#include "midi_knobs_functions.h"
#include "utils.h"


static volatile value16_t joy_y_data;
static volatile value16_t joy_x_data;
static volatile value16_t sense_data;
static volatile value16_t volume_data;

static volatile value16_t adc0_data[4];
static volatile value16_t adc1_data[4];

// See ADS1115 data sheet for explanation
static const uint8_t ADC0_SEL[] = {
    0b00000001,
    0b11000000,
    0b11100011,
};

// See ADS1115 data sheet for explanation
static const uint8_t ADC1_SEL[] = {
    0b00000001,
    0b11010000,
    0b11100011,
};

// See ADS1115 data sheet for explanation
static const uint8_t ADC2_SEL[] = {
    0b00000001,
    0b11100000,
    0b11100011,
};

// See ADS1115 data sheet for explanation
static const uint8_t ADC3_SEL[] = {
    0b00000001,
    0b11110000,
    0b11100011,
};

// See ADS1115 data sheet for explanation
static const uint8_t CONV_REG = 0b00000000;


////////////////////////////////////////////////////////
//         Analog Select MSGS
////////////////////////////////////////////////////////

static i2c_msg_t ads1015_adc00_sel = {
    .address      = 0x48,
    .bytes_rxed   = 0,
    .bytes_txed   = 0,
    .num_rx_bytes = 0,
    .rx_data      = 0,
    .state        = i2c_ready,
    .tx_data      = ADC0_SEL,
    .num_tx_bytes = 3,
};

static i2c_msg_t ads1015_adc01_sel = {
    .address      = 0x48,
    .bytes_rxed   = 0,
    .bytes_txed   = 0,
    .num_rx_bytes = 0,
    .rx_data      = 0,
    .state        = i2c_ready,
    .tx_data      = ADC1_SEL,
    .num_tx_bytes = 3,
};

static i2c_msg_t ads1015_adc02_sel = {
    .address      = 0x48,
    .bytes_rxed   = 0,
    .bytes_txed   = 0,
    .num_rx_bytes = 0,
    .rx_data      = 0,
    .state        = i2c_ready,
    .tx_data      = ADC2_SEL,
    .num_tx_bytes = 3,
};

static i2c_msg_t ads1015_adc03_sel = {
    .address      = 0x48,
    .bytes_rxed   = 0,
    .bytes_txed   = 0,
    .num_rx_bytes = 0,
    .rx_data      = 0,
    .state        = i2c_ready,
    .tx_data      = ADC3_SEL,
    .num_tx_bytes = 3,
};


static i2c_msg_t ads1015_adc10_sel = {
    .address      = 0x49,
    .bytes_rxed   = 0,
    .bytes_txed   = 0,
    .num_rx_bytes = 0,
    .rx_data      = 0,
    .state        = i2c_ready,
    .tx_data      = ADC0_SEL,
    .num_tx_bytes = 3,
};

static i2c_msg_t ads1015_adc11_sel = {
    .address      = 0x49,
    .bytes_rxed   = 0,
    .bytes_txed   = 0,
    .num_rx_bytes = 0,
    .rx_data      = 0,
    .state        = i2c_ready,
    .tx_data      = ADC1_SEL,
    .num_tx_bytes = 3,
};

static i2c_msg_t ads1015_adc12_sel = {
    .address      = 0x49,
    .bytes_rxed   = 0,
    .bytes_txed   = 0,
    .num_rx_bytes = 0,
    .rx_data      = 0,
    .state        = i2c_ready,
    .tx_data      = ADC2_SEL,
    .num_tx_bytes = 3,
};

static i2c_msg_t ads1015_adc13_sel = {
    .address      = 0x49,
    .bytes_rxed   = 0,
    .bytes_txed   = 0,
    .num_rx_bytes = 0,
    .rx_data      = 0,
    .state        = i2c_ready,
    .tx_data      = ADC3_SEL,
    .num_tx_bytes = 3,
};

////////////////////////////////////////////////////////
//            Analog read MSGS
///////////////////////////////////////////////////////

static i2c_msg_t adc00_read = {
    .address      = 0x48,
    .bytes_rxed   = 0,
    .bytes_txed   = 0,
    .num_rx_bytes = 2,
    .rx_data      = adc0_data[0].bytes,
    .state        = i2c_ready,
    .tx_data      = &CONV_REG,
    .num_tx_bytes = 1,
};

static i2c_msg_t adc01_read = {
    .address      = 0x48,
    .bytes_rxed   = 0,
    .bytes_txed   = 0,
    .num_rx_bytes = 2,
    .rx_data      = adc0_data[1].bytes,
    .state        = i2c_ready,
    .tx_data      = &CONV_REG,
    .num_tx_bytes = 1,
};

static i2c_msg_t adc02_read = {
    .address      = 0x48,
    .bytes_rxed   = 0,
    .bytes_txed   = 0,
    .num_rx_bytes = 2,
    .rx_data      = adc0_data[2].bytes,
    .state        = i2c_ready,
    .tx_data      = &CONV_REG,
    .num_tx_bytes = 1,
};

static i2c_msg_t adc03_read = {
    .address      = 0x48,
    .bytes_rxed   = 0,
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

    cursor_pos(12, 16);
    UARTprintf("        ");
    cursor_pos(12, 16);
    UARTprintf("%d", adc1_data[2].value);

    cursor_pos(13, 16);
    UARTprintf("        ");
    cursor_pos(13, 16);
    UARTprintf("%d", adc1_data[3].value);


}
void ads1x15_drawinput(int character) {

}
