bouge13a/pd_midi_synth/midi_uart_functions.h

/*
 * UART_midi_functions.h
 *
 *  Created on: Apr 15, 2021
 *      Author: steph
 */

#ifndef MIDI_UART_FUNCTIONS_H_
#define MIDI_UART_FUNCTIONS_H_

#include "host_uart_task.h"

void send_midi_message(uart_msg_u msg);



#endif /* MIDI_UART_FUNCTIONS_H_ */
