bouge13a/pd_midi_synth/homepage.h

/*
 * homepage.h
 *
 *  Created on: Aug 4, 2020
 *      Author: steph
 */

#ifndef HOMEPAGE_H_
#define HOMEPAGE_H_


void homepage_drawpage(void);
void homepage_drawdata(void);
void homepage_drawinput(int character);


#endif /* HOMEPAGE_H_ */
