bouge13a/pd_midi_synth/task_manager_page.h

/*
 * task_manager_page.h
 *
 *  Created on: Aug 8, 2020
 *      Author: steph
 */

#ifndef TASK_MANAGER_PAGE_H_
#define TASK_MANAGER_PAGE_H_

void taskmanager_drawpage(void);
void taskmanager_drawdata(void);
void taskmanager_drawinput(int character);

#endif /* TASK_MANAGER_PAGE_H_ */
