bouge13a/pd_midi_synth/(commit log)

2021-04-01 First commit, starting point for new projects
    [adc.obj, aes.obj, can.obj, comp.obj, cpu.obj, crc.obj, des.obj, eeprom.obj]
2021-04-01 Added rpi uart task
2021-04-02 added host uart, needs testing
2021-04-02 Added ADC pins
2021-04-02 added event groups, problem with two adc interrupts
    [ADC_task.c, GPIs.c, I2C_task.c, main.c]
2021-04-02 Started using ADC module 1
2021-04-03 fixed comp init issue
    [ADC_task.c, main.c]
2021-04-04 Added non pressure sensitive keys, needs testing and tab
2021-04-05 made a bunch of fixes, serial terminal broken
    [adc.obj, aes.obj, can.obj, comp.obj, cpu.obj, crc.obj, des.obj, eeprom.obj]
2021-04-05 adc works, but adding comparators breaks it
2021-04-05 removed comp ints
    [uartstdio.obj]
2021-04-06 added new adc drumpad system, made messages print to screen
2021-04-06 fixed state machine, needs pressure sense
    [drum_pad_functions.c]
2021-04-07 pressure sense works in terminal, needs debounce state
    [uartstdio.obj]
2021-04-07 added slope, still has bugs
    [drum_pad_functions.c]
2021-04-08 Pressure sense works decently, need knobs and equation
2021-04-09 moved sequence data get to interrupt
2021-04-09 works teensy, needs i2c stuff
2021-04-10 WIP added rotary encoder, needs spi
2021-04-10 Added rotary encoder with 7 seg dusplay
2021-04-10 fixed rotary encoder
2021-04-10 Adc is non deterministic need to remove event group
2021-04-11 fixed i2c error
2021-04-11 separated firmware into two boards
2021-04-11 fixed i2c driver
2021-04-12 fixed i2c task to reverse receive order
    [ADC_task.c, I2C_task.c, I2C_task.h, ads1x15_task.c, ads1x15_task.h, board_pin_defs.h, console_task.c, drum_pad_functions.c]
2021-04-14 fixed naive joystick function to send stop msg
    [ads1x15_task.c, joystick_functions.c, midi_knobs_functions.c, midi_knobs_functions.h, utils.h]
2021-04-14 fixed i2c problem, ADC was too slow
    [ads1x15_task.c]
2021-04-15 added midi buttons task and volume needs psense testing
    [uartstdio.obj]
2021-04-17 Added USB HID looper pins and started looper buttons tak
    [usbbuffer.obj, usbdaudio.obj, usbdbulk.obj, usbdcdc.obj, usbdcdesc.obj, usbdcomp.obj, usbdconfig.obj, usbddfu-rt.obj]
2021-04-17 Added looper buttons messages, changed gpis to wpd
2021-04-18 fixed usb problem, stack size too small
    [uartstdio.obj, usbdhidgamepad.obj]
2021-04-20 fixed looper buttons
    [uartstdio.obj, usbdbulk.obj, usbdhidgamepad.obj, ustdlib.obj]
2021-04-22 got teensy working with midi controller
2021-04-22 added knob uart messages
2021-04-24 fixed joystick for real this time
    [joystick_functions.c]
2021-04-25 added channel pressure
2021-05-03 made debug changes to looper
    [usbdhidgamepad.obj]
2021-05-04 fixed midi channel select
    [midi_channel_select.c]
2021-05-18 ready to add usb midi
    [adc.obj, aes.obj, can.obj, comp.obj, cpu.obj, crc.obj, des.obj, eeprom.obj]
2021-06-09 not really sure
    [usbmidi.obj, usbmidi_handlers.obj]
2022-02-10 fixed linking problems
    [uartstdio.obj, ustdlib.obj]
2022-02-10 added hardware
    [ADC.sch, Assembly.STEP, LED_Board - Copy.kicad_pcb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]
